scottcampbellRR/SolidWorksFiles/Machined Parts - 2024-10-08/Front Housing.STEP

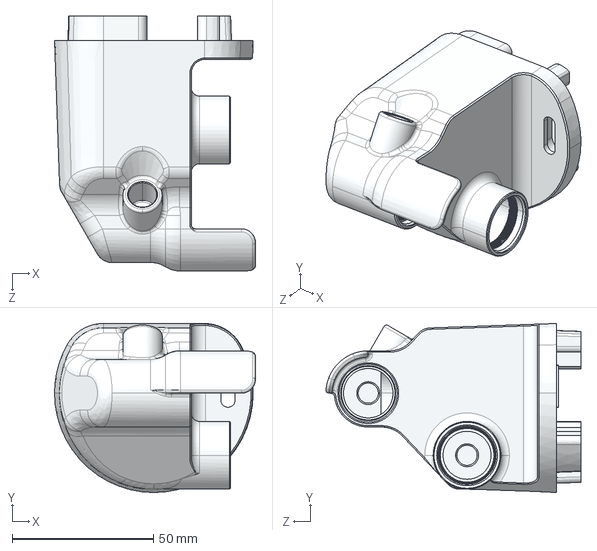
[picture p1: CAD file, 2024-12-03]
Machined Parts - 2024-10-08/Front Housing.STEP
71.2 x 59.9 x 90.3 mm
