scottcampbellRR/SolidWorksFiles/Machined Parts -2025-04-07-R01 RELEASED/RCDT-PR-003 - Bore Cap R01.STEP

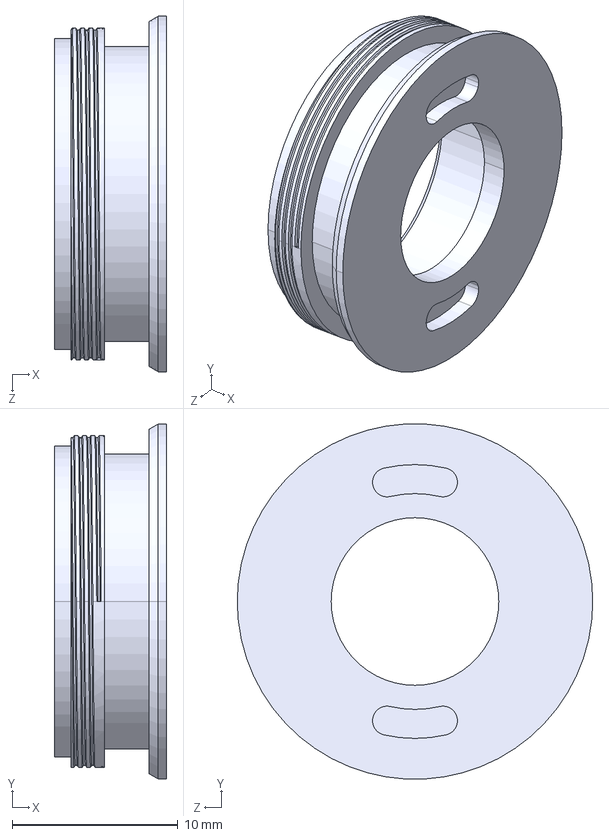
[picture p2: CAD file, 2025-04-08]
Machined Parts -2025-04-07-R01 RELEASED/RCDT-PR-003 - Bore Cap R01.STEP
6.75 x 21.4 x 21.4 mm
