scottcampbellRR/SolidWorksFiles/Machined Parts -2025-04-07-R01 RELEASED/RCDT-PR-004 Guard R01.STEP

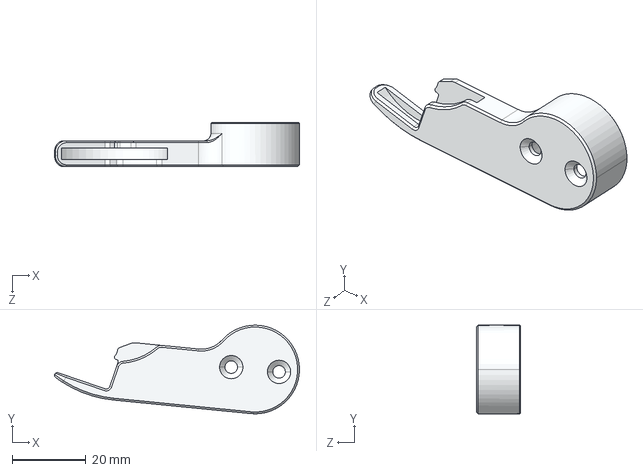
[picture p3: CAD file, 2025-04-08]
Machined Parts -2025-04-07-R01 RELEASED/RCDT-PR-004 Guard R01.STEP
66.3 x 24.0 x 12.0 mm
