scottcampbellRR/SolidWorksFiles/Machined Parts -2025-04-07-R01 RELEASED/RCDT-PR-001 Front Housing R02.STEP

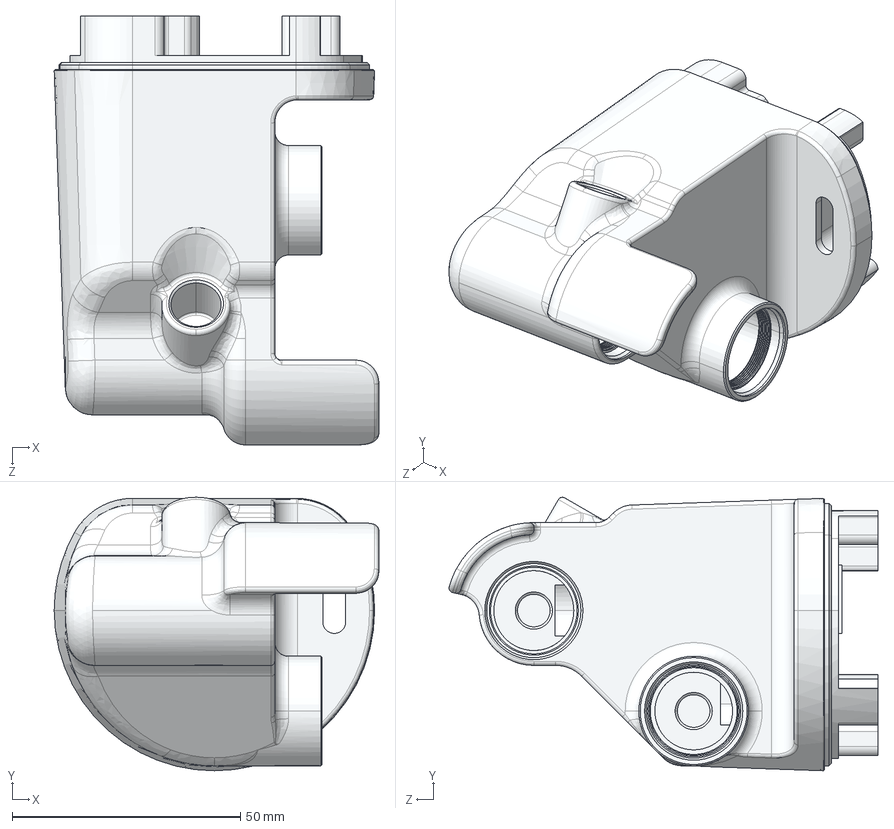
[picture p4: CAD file, 2025-04-08]
Machined Parts -2025-04-07-R01 RELEASED/RCDT-PR-001 Front Housing R02.STEP
71.1 x 59.9 x 93.9 mm
