scottcampbellRR/SolidWorksFiles/Machined Parts -2025-04-07-R01 RELEASED/RCDT-PR-008 Guard Shaft Collar R01.STEP

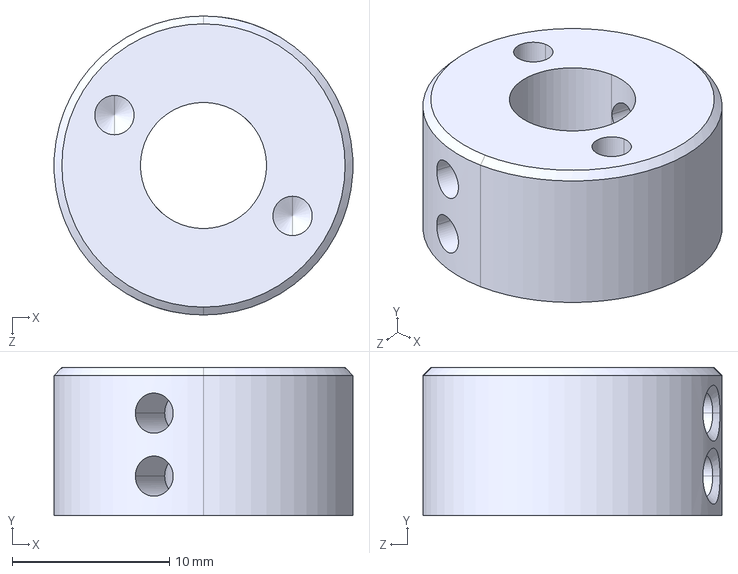
[picture p6: CAD file, 2025-04-08]
Machined Parts -2025-04-07-R01 RELEASED/RCDT-PR-008 Guard Shaft Collar R01.STEP
19.0 x 9.40 x 19.0 mm
