scottcampbellRR/SolidWorksFiles/Machined Parts -2025-04-07-R01 RELEASED/RCDT-PR-005 Blade Lock R01.STEP

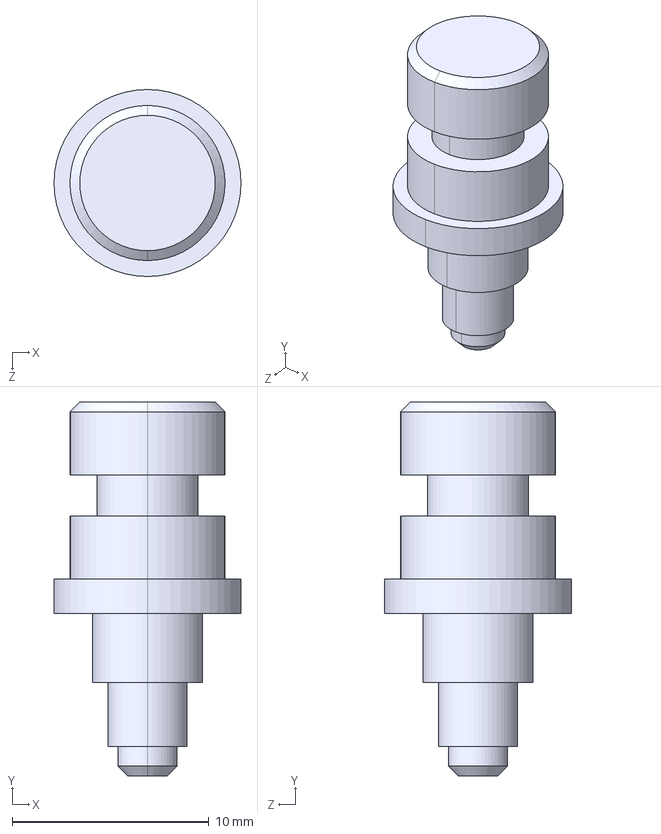
[picture p7: CAD file, 2025-04-08]
Machined Parts -2025-04-07-R01 RELEASED/RCDT-PR-005 Blade Lock R01.STEP
9.50 x 19.0 x 9.50 mm
