scottcampbellRR/SolidWorksFiles/Machined Parts -2025-04-07-R01 RELEASED/RCDT-PR-002 - Driveshaft R01.STEP

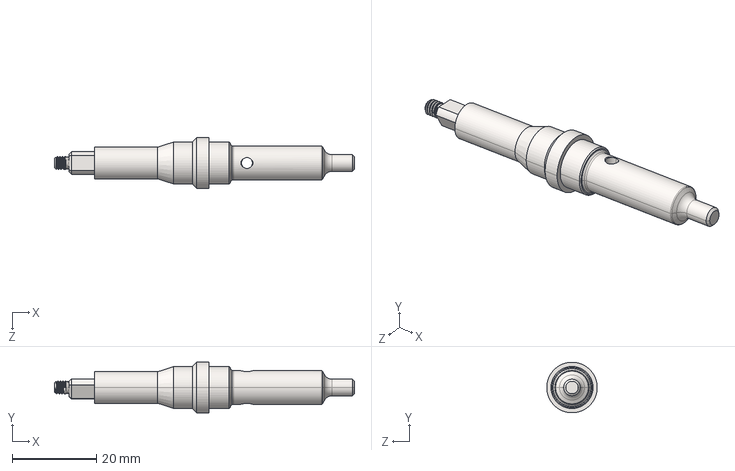
[picture p8: CAD file, 2025-04-08]
Machined Parts -2025-04-07-R01 RELEASED/RCDT-PR-002 - Driveshaft R01.STEP
71.2 x 12.0 x 12.0 mm
