scottcampbellRR/SolidWorksFiles/Machined Parts -2025-04-07-R01 RELEASED/RCDT-PR-007 Actuator Arm R01.STEP

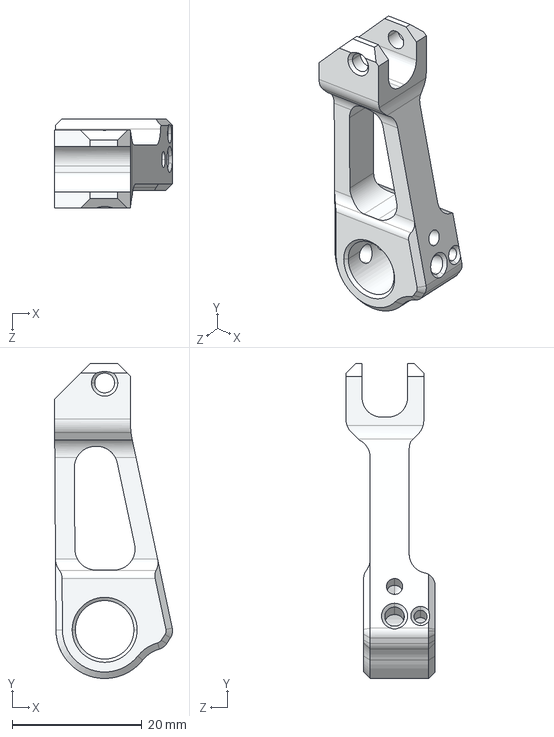
[picture p10: CAD file, 2025-04-08]
Machined Parts -2025-04-07-R01 RELEASED/RCDT-PR-007 Actuator Arm R01.STEP
18.2 x 48.5 x 13.8 mm
