scottcampbellRR/SolidWorksFiles/Machined Parts - 2024-10-08/Guard.STEP

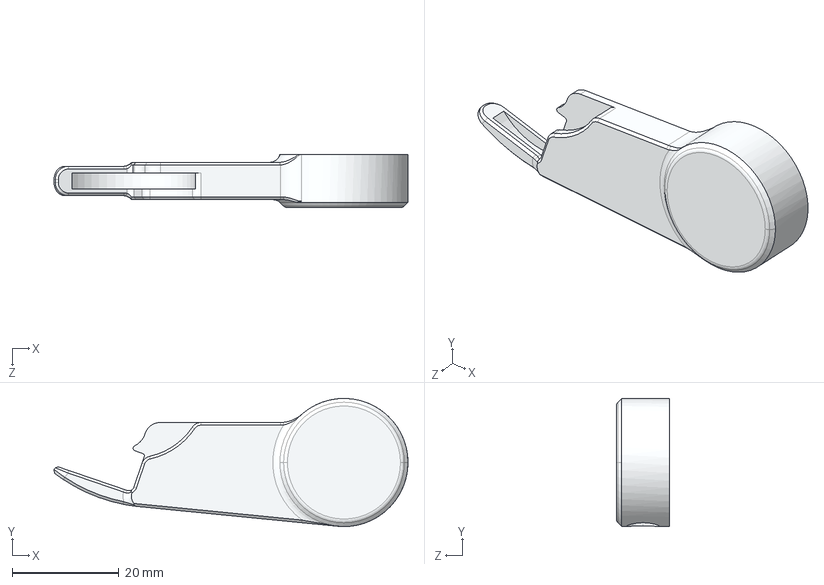
[picture p11: CAD file, 2024-12-03]
Machined Parts - 2024-10-08/Guard.STEP
66.3 x 24.0 x 10.0 mm
