scottcampbellRR/SolidWorksFiles/Machined Parts -2025-04-07-R01 RELEASED/RCDT-PR-006 Guard Shaft R01.STEP

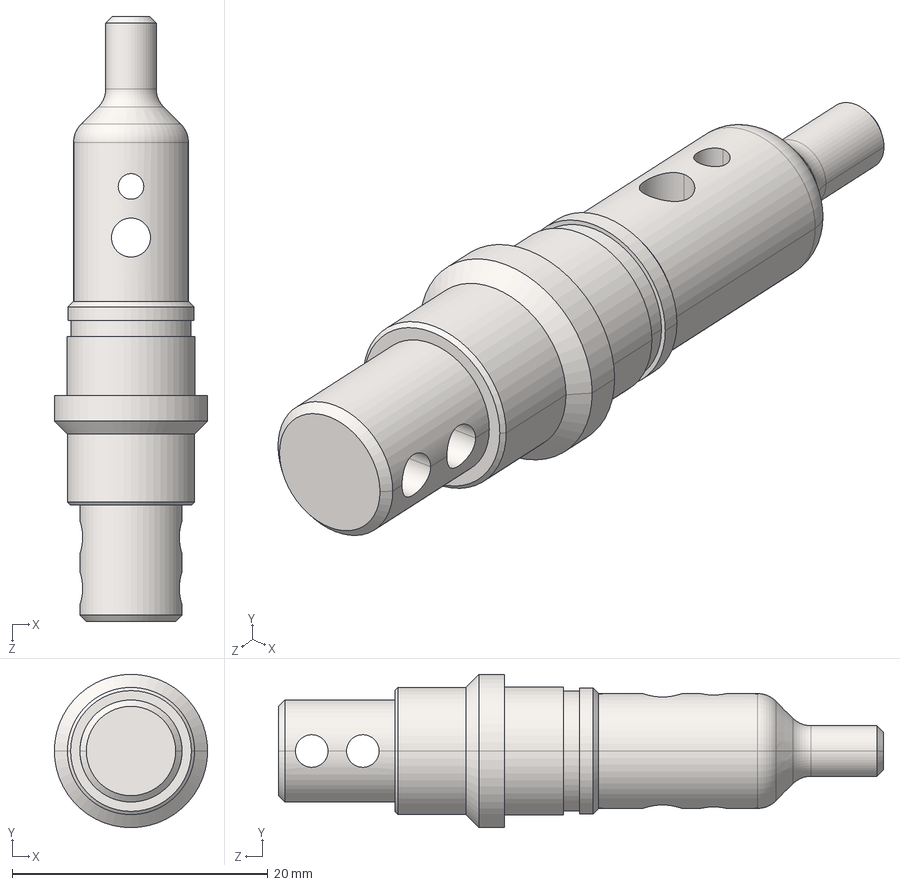
[picture p12: CAD file, 2025-04-08]
Machined Parts -2025-04-07-R01 RELEASED/RCDT-PR-006 Guard Shaft R01.STEP
12.0 x 12.0 x 47.4 mm
