scottcampbellRR/SolidWorksFiles/Machined Parts - 2024-10-08/Actuator Arm.STEP

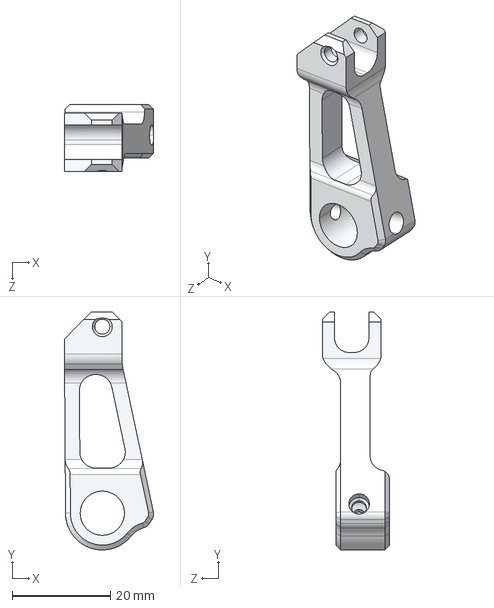
[picture p13: CAD file, 2024-12-03]
Machined Parts - 2024-10-08/Actuator Arm.STEP
18.2 x 48.5 x 13.8 mm
