scottcampbellRR/SolidWorksFiles/Machined Parts - 2024-10-08/Driveshaft.STEP

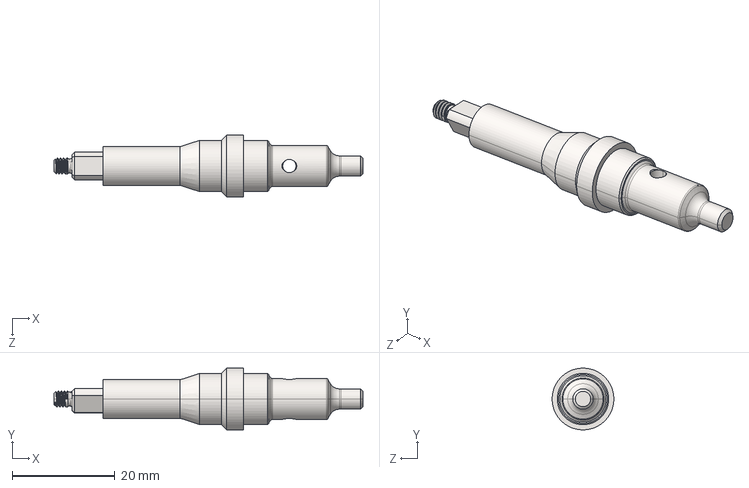
[picture p14: CAD file, 2024-12-03]
Machined Parts - 2024-10-08/Driveshaft.STEP
60.0 x 12.0 x 12.0 mm
