scottcampbellRR/SolidWorksFiles/Machined Parts - 2024-10-08/Shoulder Bolt.STEP

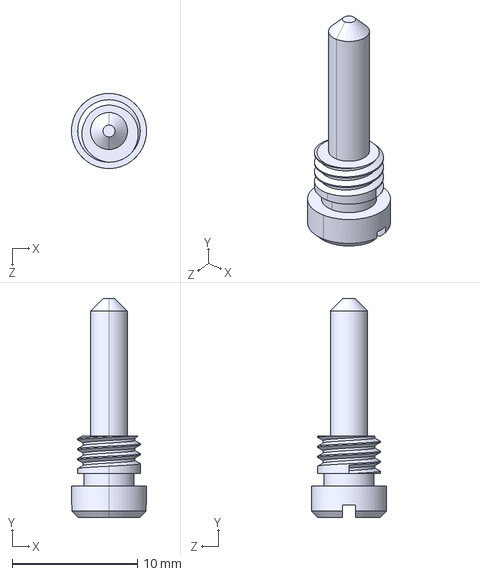
[picture p16: CAD file, 2024-12-03]
Machined Parts - 2024-10-08/Shoulder Bolt.STEP
6.00 x 17.5 x 6.00 mm
