scottcampbellRR/SolidWorksFiles/(list of files, cad)

Other CAD files:
Machined Parts - 2024-10-08/Front Housing_REV2.STEP
Machined Parts - 2024-10-08/Bore Cap.STEP
Machined Parts - 2024-10-08/Thumbscrew.STEP
