scottcampbellRR/SolidWorksFiles/Machined Parts -2025-04-07-R01 RELEASED/RCDT-PR-004 Guard Drawing R01.PDF

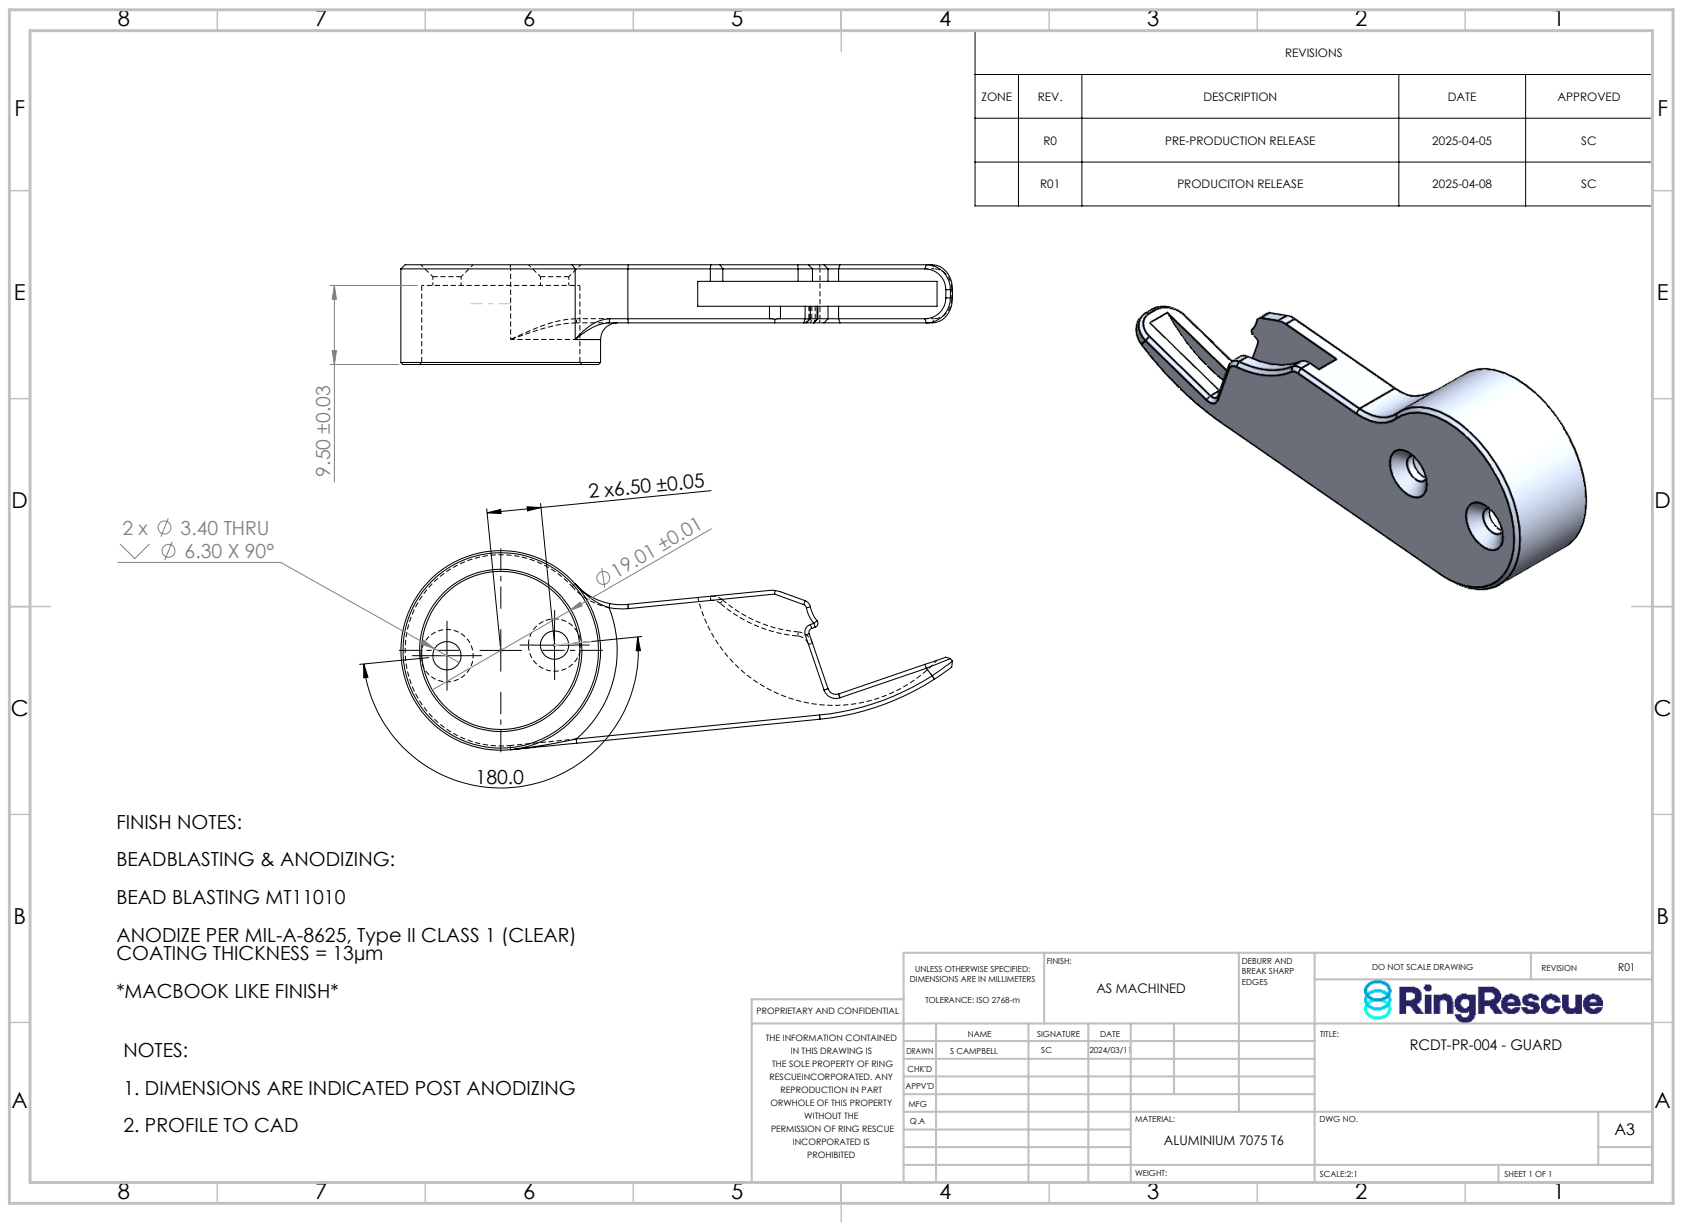
[picture p20: page 1]
3.40 THRU; FINISH:; DEBURR AND; BREAK SHARP; DO NOT SCALE DRAWING; REVISION; SCALE:2:1; SHEET 1 OF 1; AS MACHINED

REVISIONS

ZONE | REV. | DESCRIPTION | DATE | APPROVED

R0 | PRE-PRODUCTION RELEASE | 2025-04-05 | SC

R01 | PRODUCITON RELEASE | 2025-04-08 | SC

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

UNLESS OTHERWISE SPECIFIED:
DIMENSIONS ARE IN MILLIMETERS
TOLERANCE: ISO 2768-m

PROPRIETARY AND CONFIDENTIAL

NOTES:
1. DIMENSIONS ARE INDICATED POST ANODIZING
2. PROFILE TO CAD

IN THIS DRAWING IS THE SOLE PROPERTY OF RING RESCUEINCORPORATED. ANY REPRODUCTION IN PART ORWHOLE OF THIS PROPERTY WITHOUT THE PERMISSION OF RING RESCUE INCORPORATED IS PROHIBITED | | NAME | SIGNATURE THE INFORMATION CONTAINED | DATE | | | TITLE: RCDT-PR-004 - GUARD

DRAWN | S CAMPBELL | SC | 2024/03/11
CHK'D
APPV'D
MFG
Q.A | | | | MATERIAL: | DWG NO. | A3 ALUMINIUM 7075 T6
