scottcampbellRR/SolidWorksFiles/Machined Parts -2025-04-07-R01 RELEASED/RCDT-PR-005 Blade Lock Drawing R01.PDF

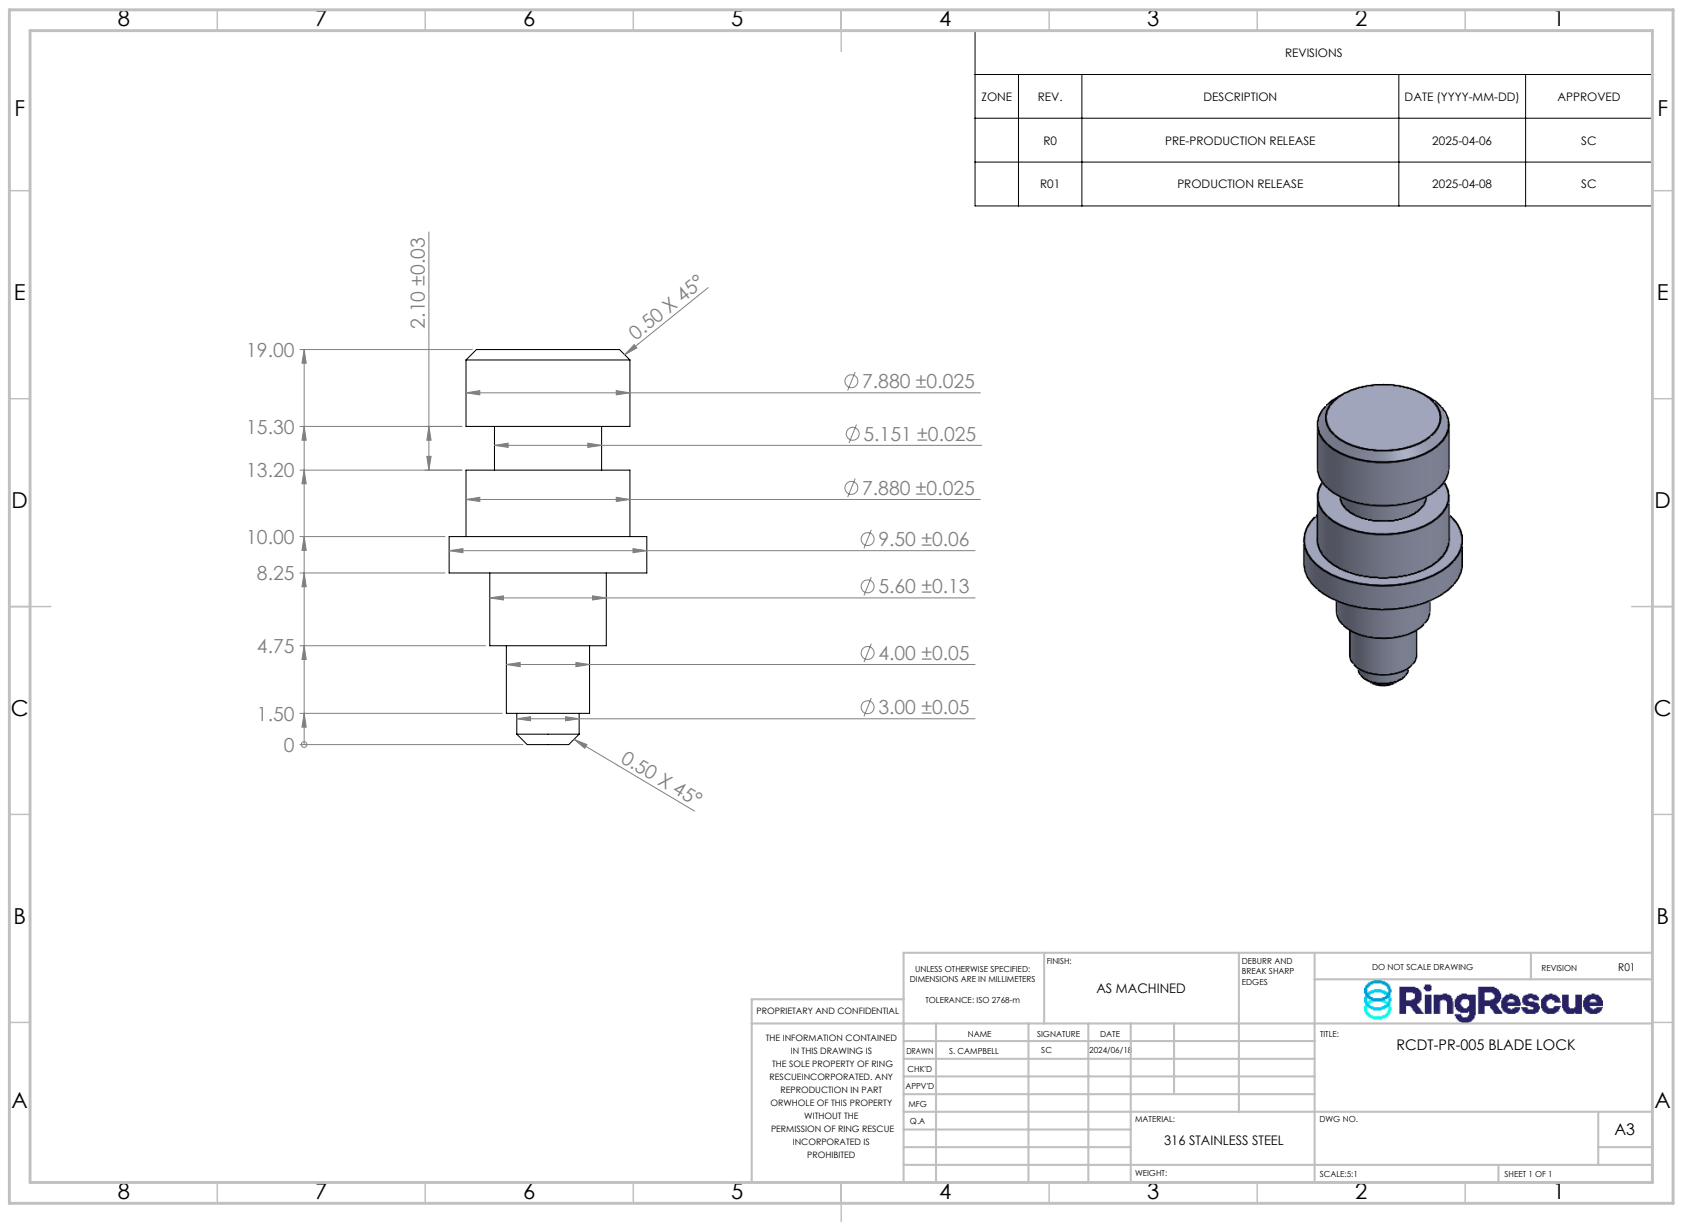
[picture p21: page 1]
FINISH:; DEBURR AND; BREAK SHARP; DO NOT SCALE DRAWING; REVISION; SCALE:5:1; SHEET 1 OF 1; AS MACHINED

REVISIONS

ZONE | REV. | DESCRIPTION | DATE (YYYY-MM-DD) | APPROVED

R0 | PRE-PRODUCTION RELEASE | 2025-04-06 | SC

R01 | PRODUCTION RELEASE | 2025-04-08 | SC

UNLESS OTHERWISE SPECIFIED:
DIMENSIONS ARE IN MILLIMETERS
TOLERANCE: ISO 2768-m

PROPRIETARY AND CONFIDENTIAL

IN THIS DRAWING IS THE SOLE PROPERTY OF RING RESCUEINCORPORATED. ANY REPRODUCTION IN PART ORWHOLE OF THIS PROPERTY WITHOUT THE PERMISSION OF RING RESCUE INCORPORATED IS PROHIBITED | | NAME | SIGNATURE THE INFORMATION CONTAINED | DATE | | | TITLE: RCDT-PR-005 BLADE LOCK

DRAWN | S. CAMPBELL | SC | 2024/06/18
CHK'D
APPV'D
MFG
Q.A | | | | MATERIAL: | DWG NO. | A3 316 STAINLESS STEEL
