scottcampbellRR/SolidWorksFiles/Machined Parts -2025-04-07-R01 RELEASED/RCDT-PR-006 Guard Shaft Drawing R01.PDF

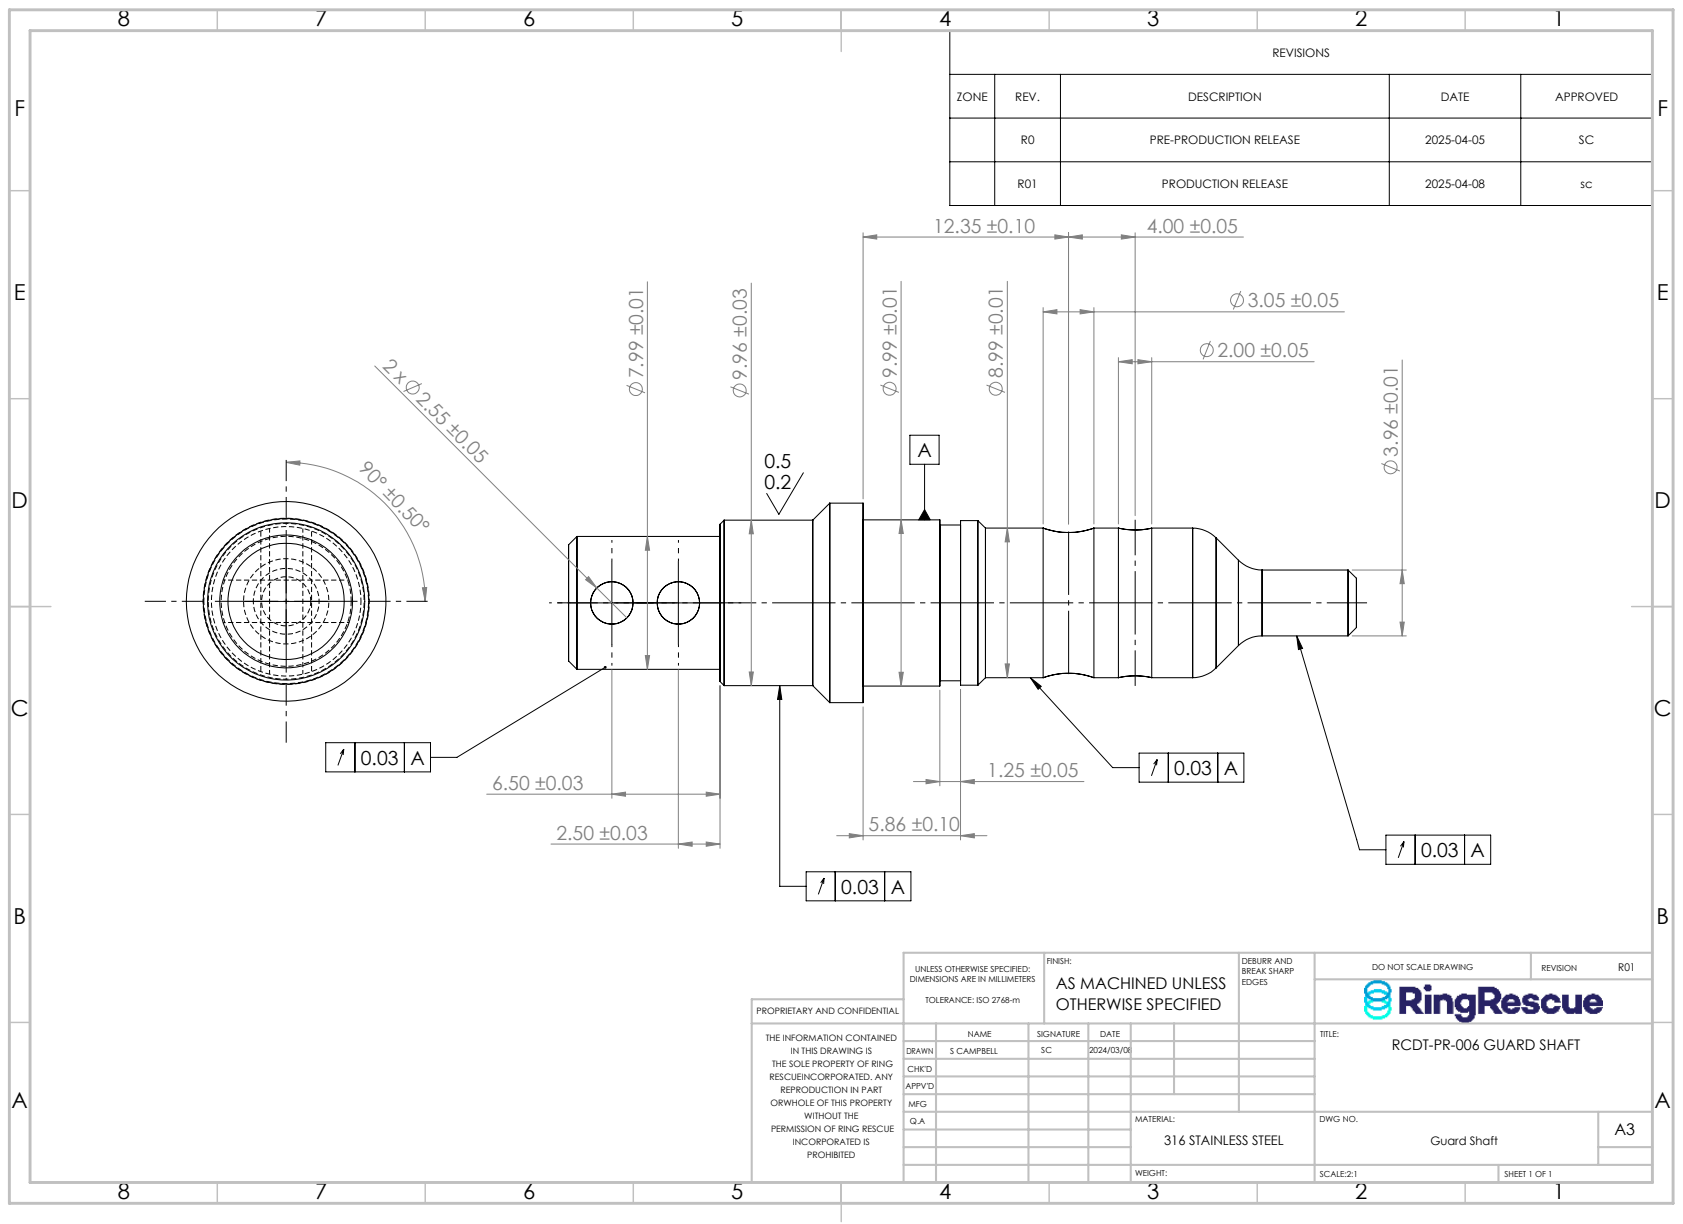
[picture p22: page 1]
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

REVISIONS

ZONE | REV. | DESCRIPTION | DATE | APPROVED

R0 | PRE-PRODUCTION RELEASE | 2025-04-05 | SC

R01 | PRODUCTION RELEASE | 2025-04-08 | sc

AS MACHINED UNLESS
OTHERWISE SPECIFIED

UNLESS OTHERWISE SPECIFIED:
DIMENSIONS ARE IN MILLIMETERS
TOLERANCE: ISO 2768-m

PROPRIETARY AND CONFIDENTIAL

IN THIS DRAWING IS THE SOLE PROPERTY OF RING RESCUEINCORPORATED. ANY REPRODUCTION IN PART ORWHOLE OF THIS PROPERTY WITHOUT THE PERMISSION OF RING RESCUE INCORPORATED IS PROHIBITED | | NAME | SIGNATURE THE INFORMATION CONTAINED | DATE | | | TITLE: RCDT-PR-006 GUARD SHAFT

DRAWN | S CAMPBELL | SC | 2024/03/08
CHK'D
APPV'D
MFG
Q.A | | | | MATERIAL: | DWG NO. Guard Shaft | A3 316 STAINLESS STEEL
