scottcampbellRR/SolidWorksFiles/Machined Parts -2025-04-07-R01 RELEASED/RDCT-PR-001 Front Housing Drawing R01.PDF

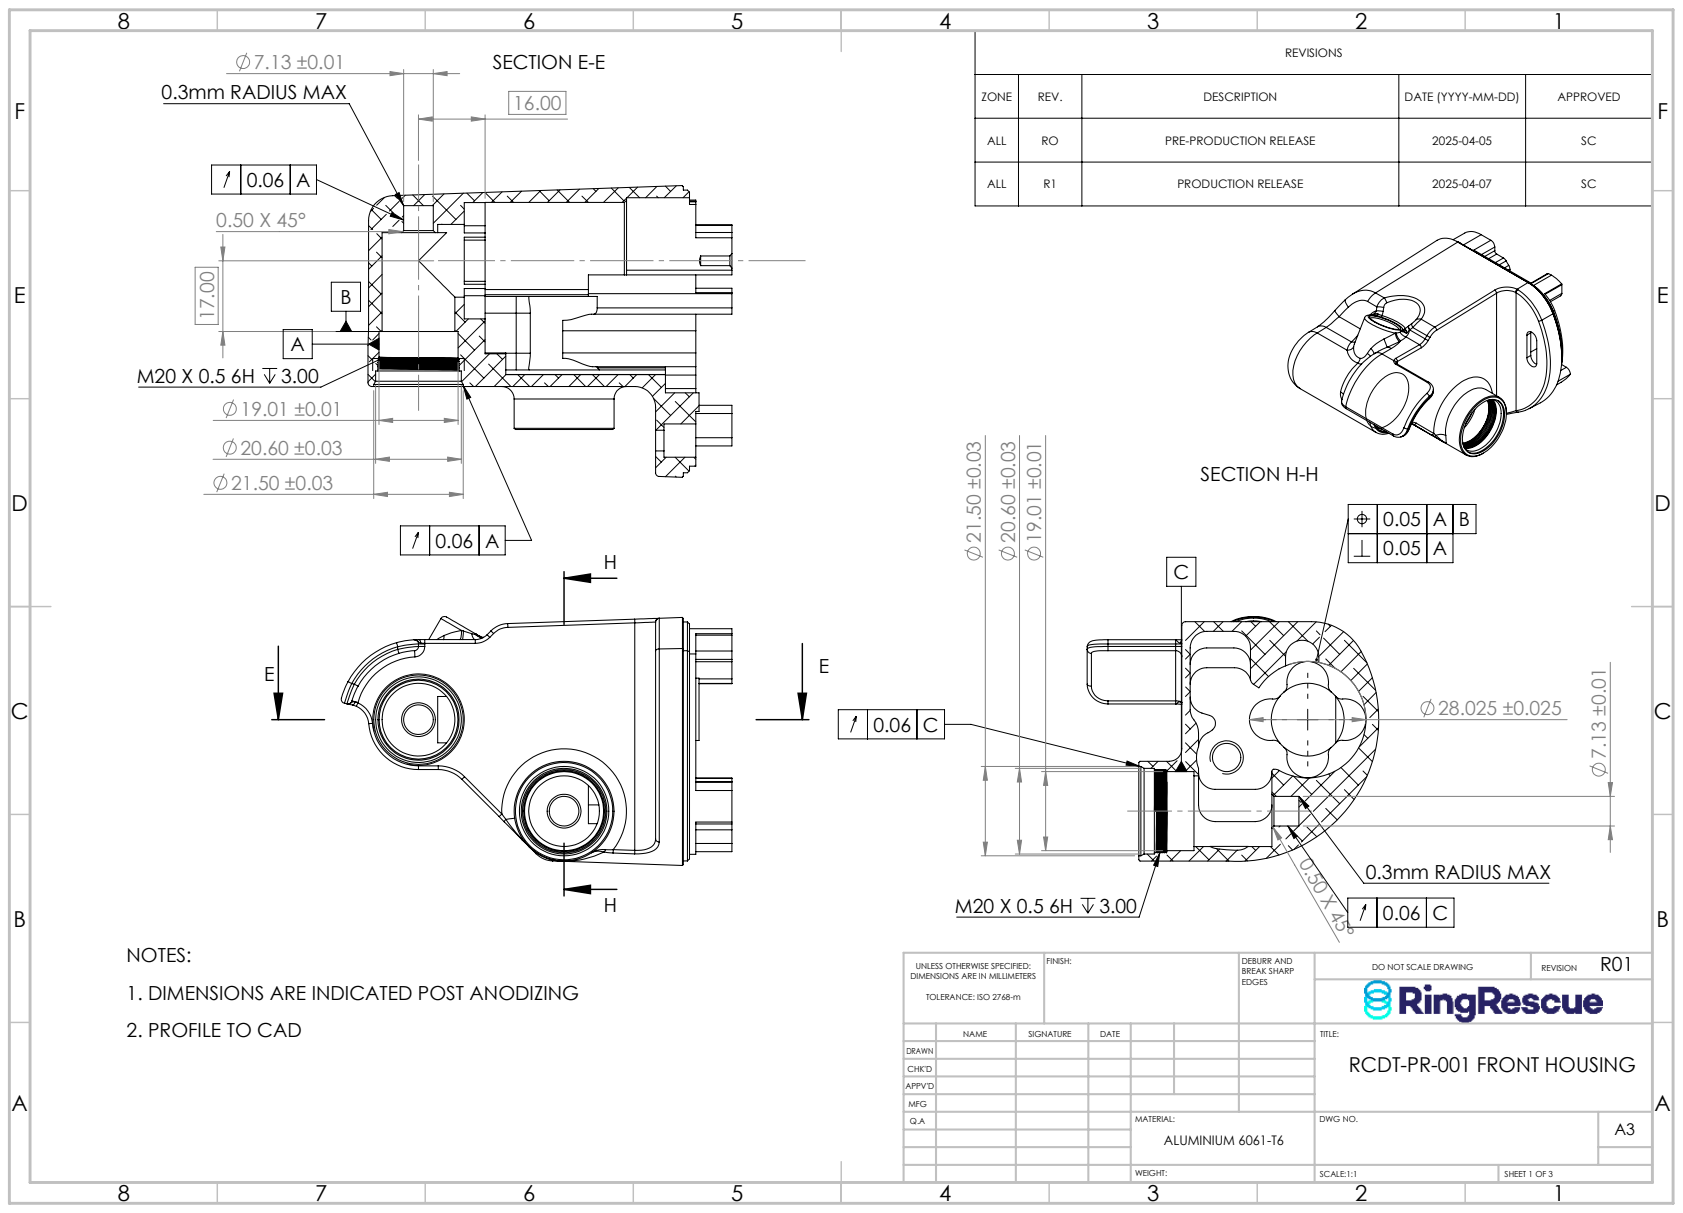
[picture p23: page 1]
0.3mm RADIUS MAX; SECTION H-H; FINISH:; DEBURR AND; BREAK SHARP; DO NOT SCALE DRAWING; REVISION; SCALE:1:1; SHEET 1 OF 3

SECTION E-E 7.13 ±0.01 | REVISIONS

ZONE | REV. | DESCRIPTION | DATE (YYYY-MM-DD) | APPROVED

ALL | RO | PRE-PRODUCTION RELEASE | 2025-04-05 | SC

ALL | R1 | PRODUCTION RELEASE | 2025-04-07 | SC

NOTES:
1. DIMENSIONS ARE INDICATED POST ANODIZING
2. PROFILE TO CAD

UNLESS OTHERWISE SPECIFIED:
DIMENSIONS ARE IN MILLIMETERS
TOLERANCE: ISO 2768-m

NAME | SIGNATURE | DATE | | | | TITLE: RCDT-PR-001 FRONT HOUSING

DRAWN
CHK'D
APPV'D
MFG
Q.A | | | | MATERIAL: | DWG NO. | A3 ALUMINIUM 6061-T6

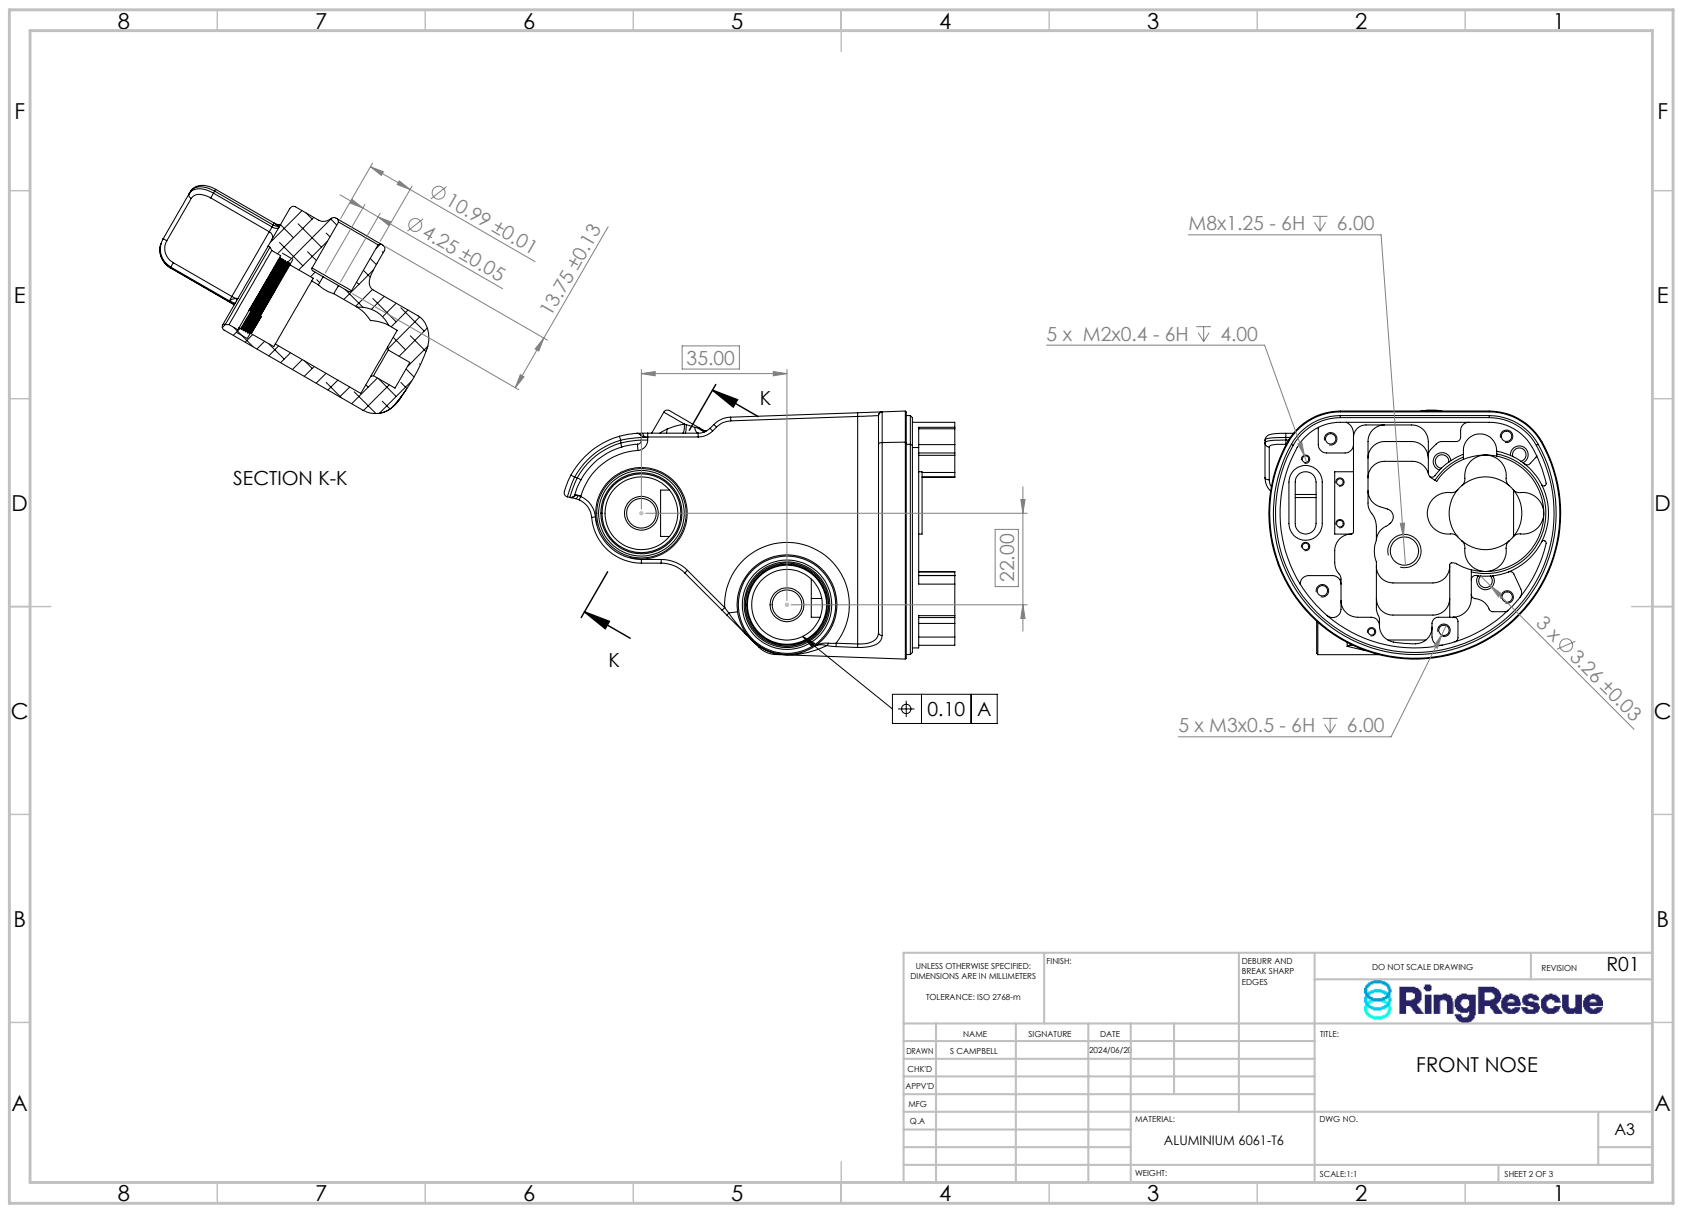
[picture p24: page 2]
SECTION K-K; FINISH:; DEBURR AND; BREAK SHARP; DO NOT SCALE DRAWING; REVISION

UNLESS OTHERWISE SPECIFIED:
DIMENSIONS ARE IN MILLIMETERS
TOLERANCE: ISO 2768-m

NAME | SIGNATURE | DATE | TITLE:

DRAWN | | | 2024/06/20 | FRONT NOSE S CAMPBELL
CHK'D
APPV'D
MFG

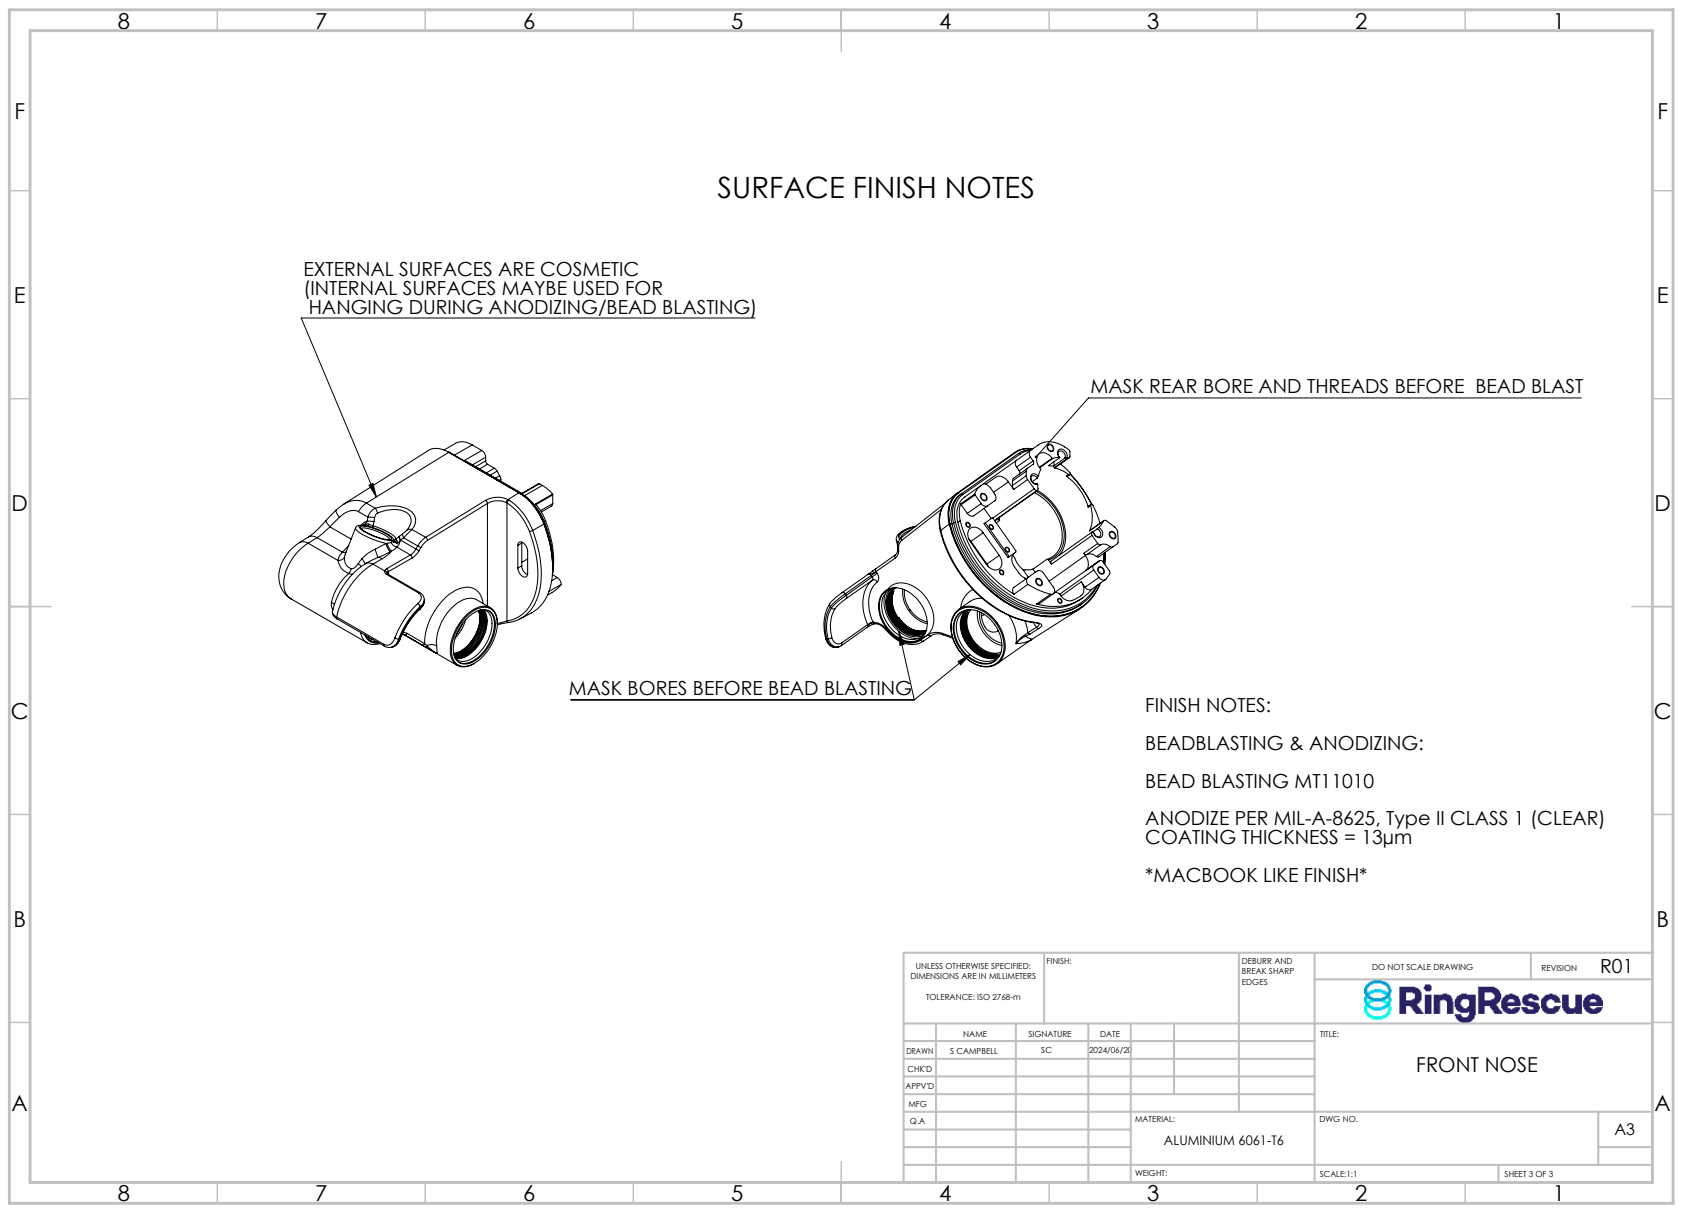
[picture p25: page 3]
FINISH:; DEBURR AND; BREAK SHARP; DO NOT SCALE DRAWING; REVISION

SURFACE FINISH NOTES

EXTERNAL SURFACES ARE COSMETIC
(INTERNAL SURFACES MAYBE USED FOR
HANGING DURING ANODIZING/BEAD BLASTING)

MASK REAR BORE AND THREADS BEFORE BEAD BLAST

MASK BORES BEFORE BEAD BLASTING

FINISH NOTES:
BEADBLASTING & ANODIZING:
BEAD BLASTING MT11010
ANODIZE PER MIL-A-8625, Type II CLASS 1 (CLEAR)
COATING THICKNESS = 13µm
*MACBOOK LIKE FINISH*

UNLESS OTHERWISE SPECIFIED:
DIMENSIONS ARE IN MILLIMETERS
TOLERANCE: ISO 2768-m

NAME | SIGNATURE | DATE | TITLE:

DRAWN | | SC | 2024/06/20 | FRONT NOSE S CAMPBELL
CHK'D
APPV'D
MFG
