scottcampbellRR/SolidWorksFiles/Machined Parts - 2025-04-07-R0 RELEASED/RCDT-PR-007 Actuator Arm Drawing R0.PDF

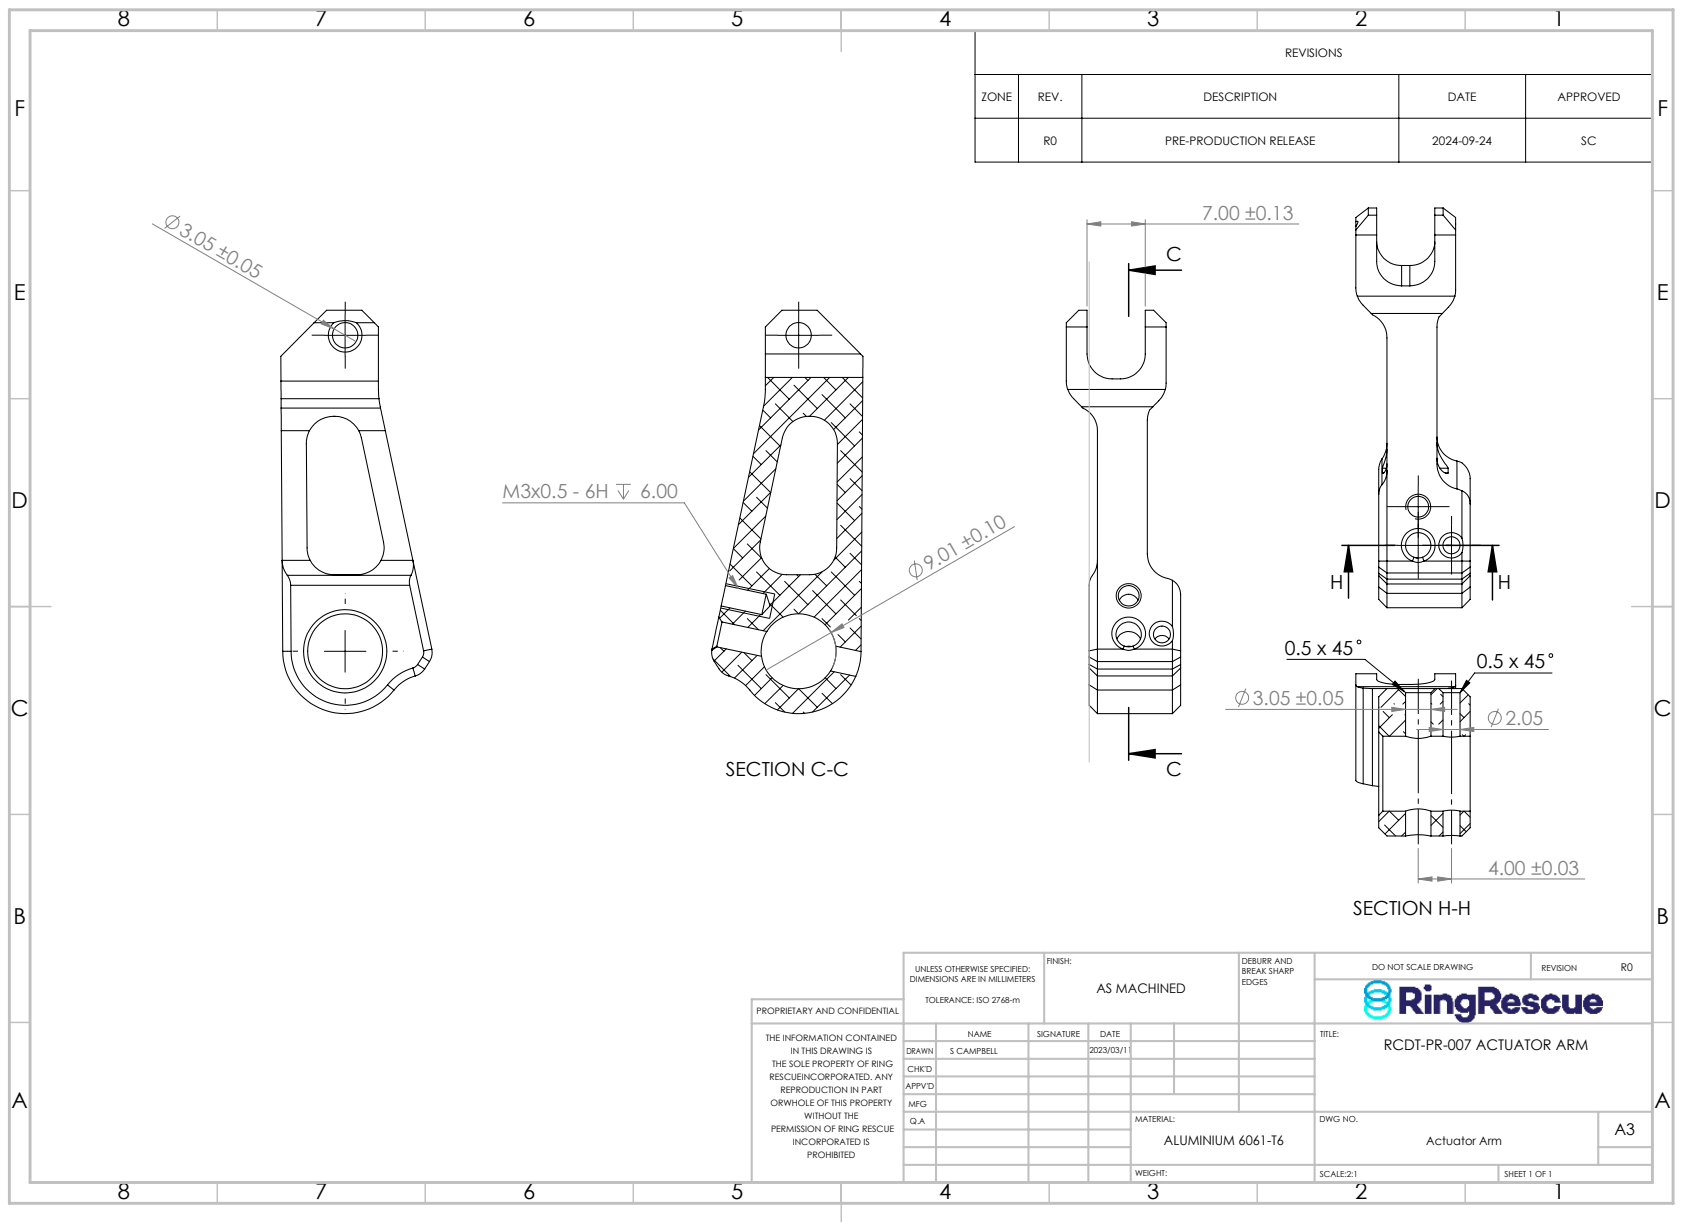
[picture p26: page 1]
SECTION C-C; SECTION H-H; FINISH:; DEBURR AND; BREAK SHARP; DO NOT SCALE DRAWING; REVISION; SCALE:2:1; SHEET 1 OF 1; AS MACHINED

REVISIONS

ZONE | REV. | DESCRIPTION | DATE | APPROVED

R0 | PRE-PRODUCTION RELEASE | 2024-09-24 | SC

UNLESS OTHERWISE SPECIFIED:
DIMENSIONS ARE IN MILLIMETERS
TOLERANCE: ISO 2768-m

PROPRIETARY AND CONFIDENTIAL

IN THIS DRAWING IS THE SOLE PROPERTY OF RING RESCUEINCORPORATED. ANY REPRODUCTION IN PART ORWHOLE OF THIS PROPERTY WITHOUT THE PERMISSION OF RING RESCUE INCORPORATED IS PROHIBITED | | NAME | SIGNATURE THE INFORMATION CONTAINED | DATE | | | TITLE: RCDT-PR-007 ACTUATOR ARM

DRAWN | S CAMPBELL | | 2023/03/11
CHK'D
APPV'D
MFG
Q.A | | | | MATERIAL: | DWG NO. Actuator Arm | A3 ALUMINIUM 6061-T6
