scottcampbellRR/SolidWorksFiles/Machined Parts - 2024-10-08/Driveshaft Drawing.pdf

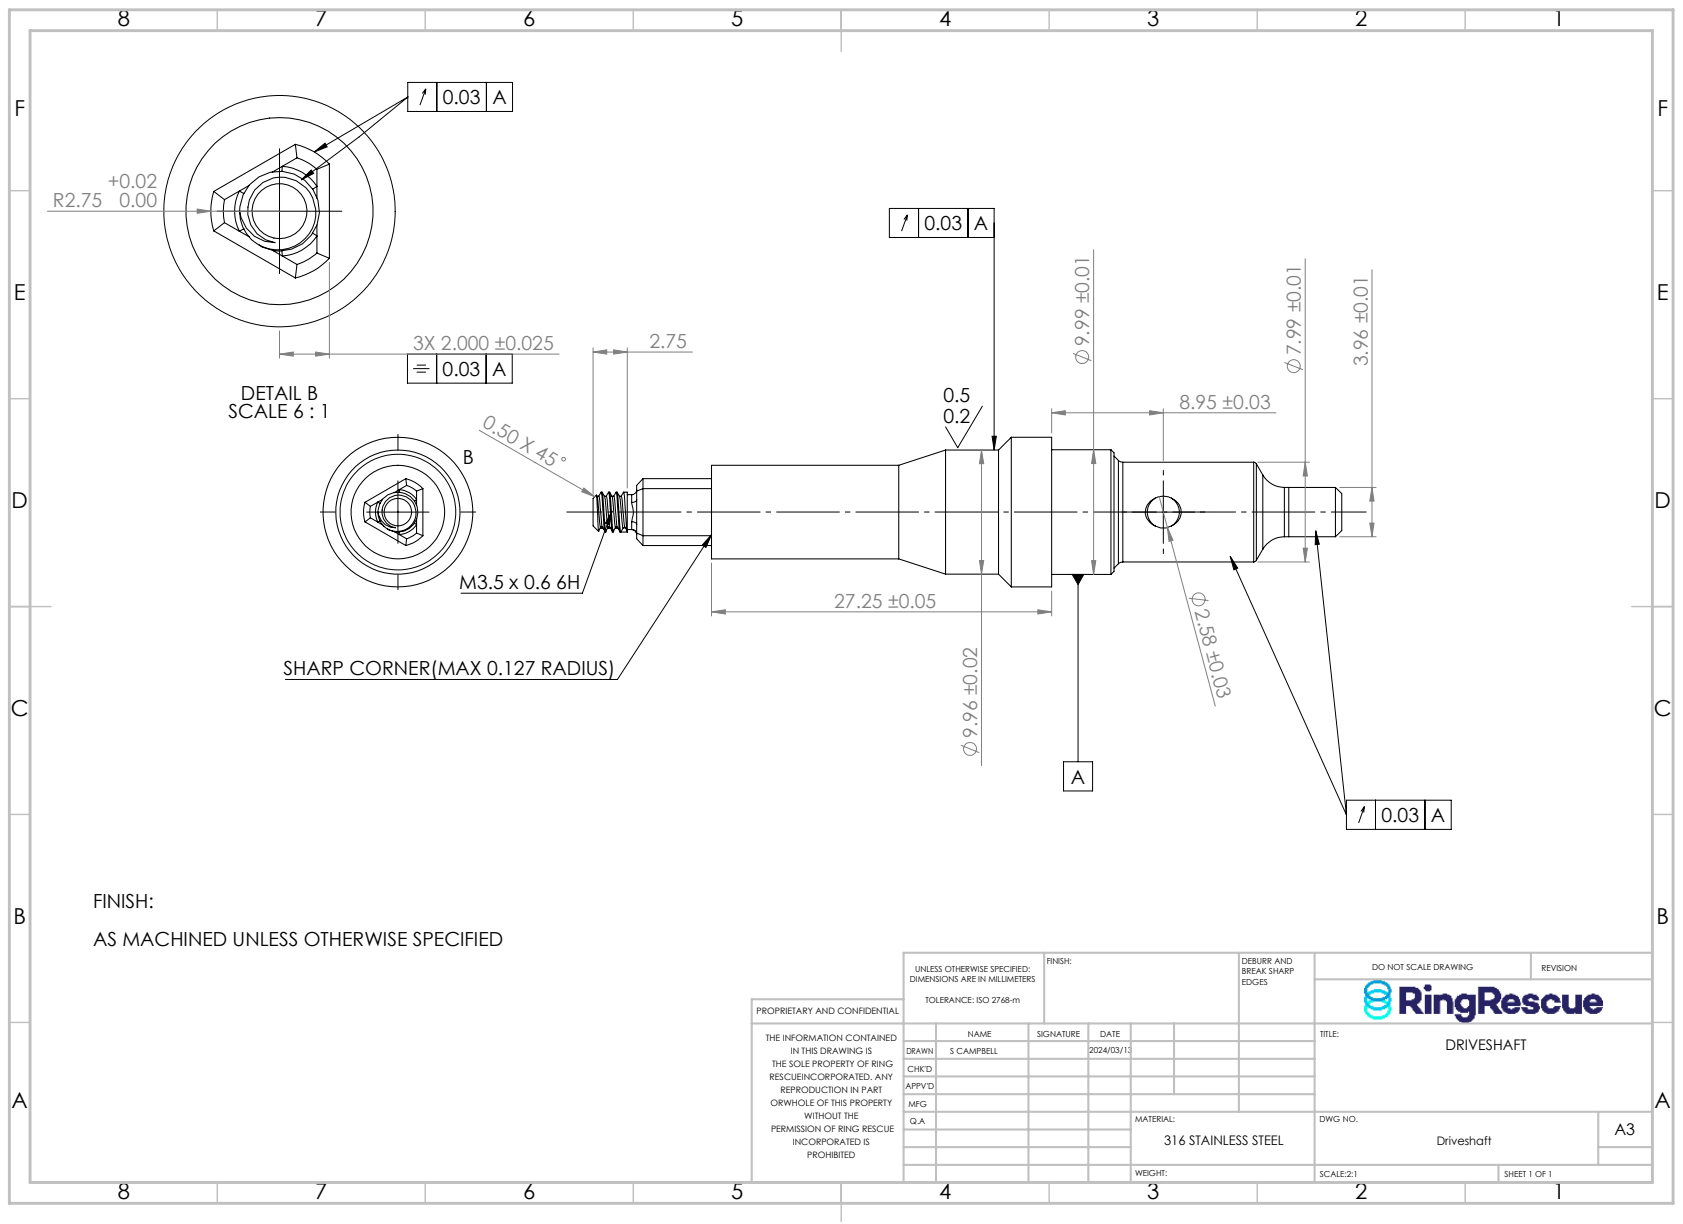
[picture p30: page 1]
DETAIL B SCALE 6 : 1; FINISH:; DEBURR AND; BREAK SHARP; DO NOT SCALE DRAWING; REVISION; SCALE:2:1; SHEET 1 OF 1

SHARP CORNER(MAX 0.127 RADIUS)

FINISH:
AS MACHINED UNLESS OTHERWISE SPECIFIED

UNLESS OTHERWISE SPECIFIED:
DIMENSIONS ARE IN MILLIMETERS
TOLERANCE: ISO 2768-m

PROPRIETARY AND CONFIDENTIAL

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

DRAWN | | | 2024/03/13 | | | DRIVESHAFT S CAMPBELL

CHK'D
APPV'D
MFG
Q.A | | | | MATERIAL: | DWG NO. Driveshaft | A3 316 STAINLESS STEEL
