scottcampbellRR/SolidWorksFiles/Machined Parts - 2024-10-08/Front Housing Drawing.pdf

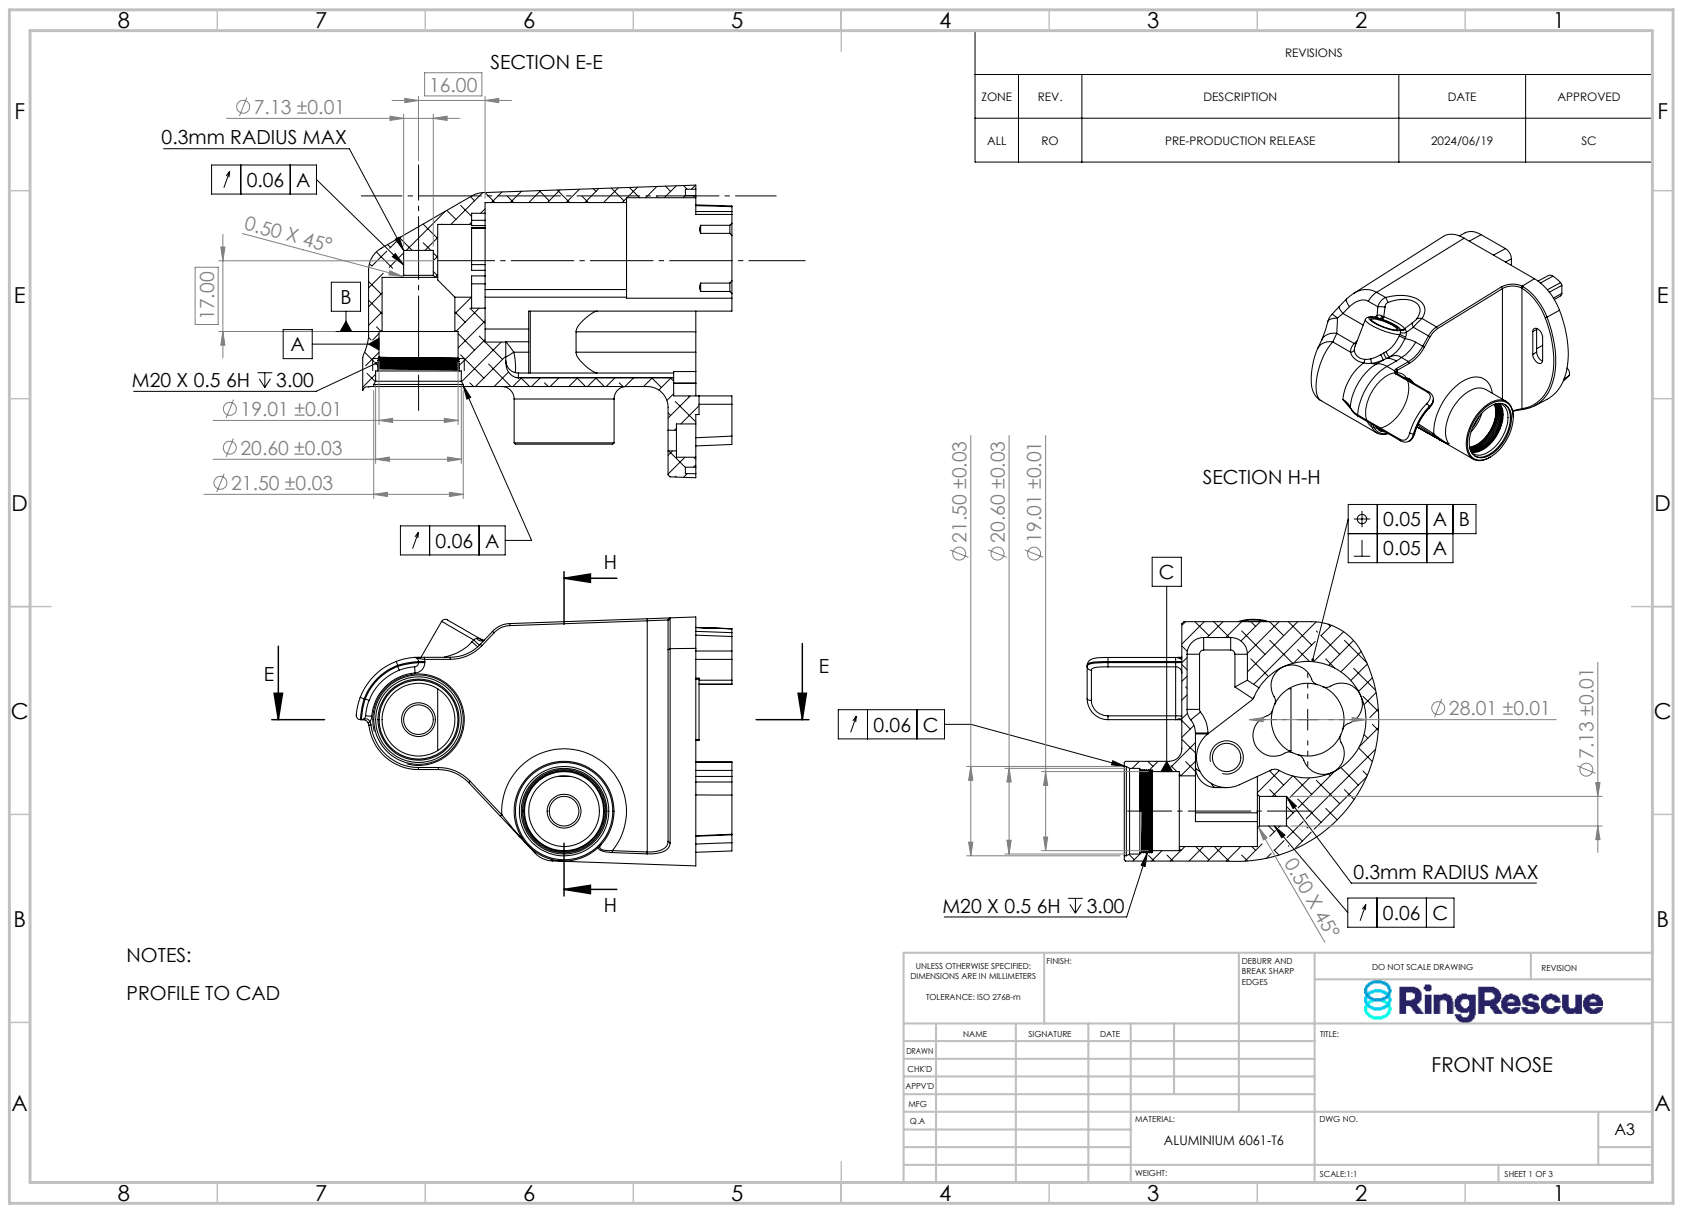
[picture p31: page 1]
SECTION E-E; 0.3mm RADIUS MAX; SECTION H-H; ALL; PRE-PRODUCTION RELEASE; FINISH:; DEBURR AND; BREAK SHARP; DO NOT SCALE DRAWING; REVISION; SCALE:1:1; SHEET 1 OF 3

NOTES:
PROFILE TO CAD

UNLESS OTHERWISE SPECIFIED:
DIMENSIONS ARE IN MILLIMETERS
TOLERANCE: ISO 2768-m

NAME | SIGNATURE | DATE | | | | TITLE: FRONT NOSE

DRAWN
CHK'D
APPV'D
MFG
Q.A | | | | MATERIAL: | DWG NO. | A3 ALUMINIUM 6061-T6

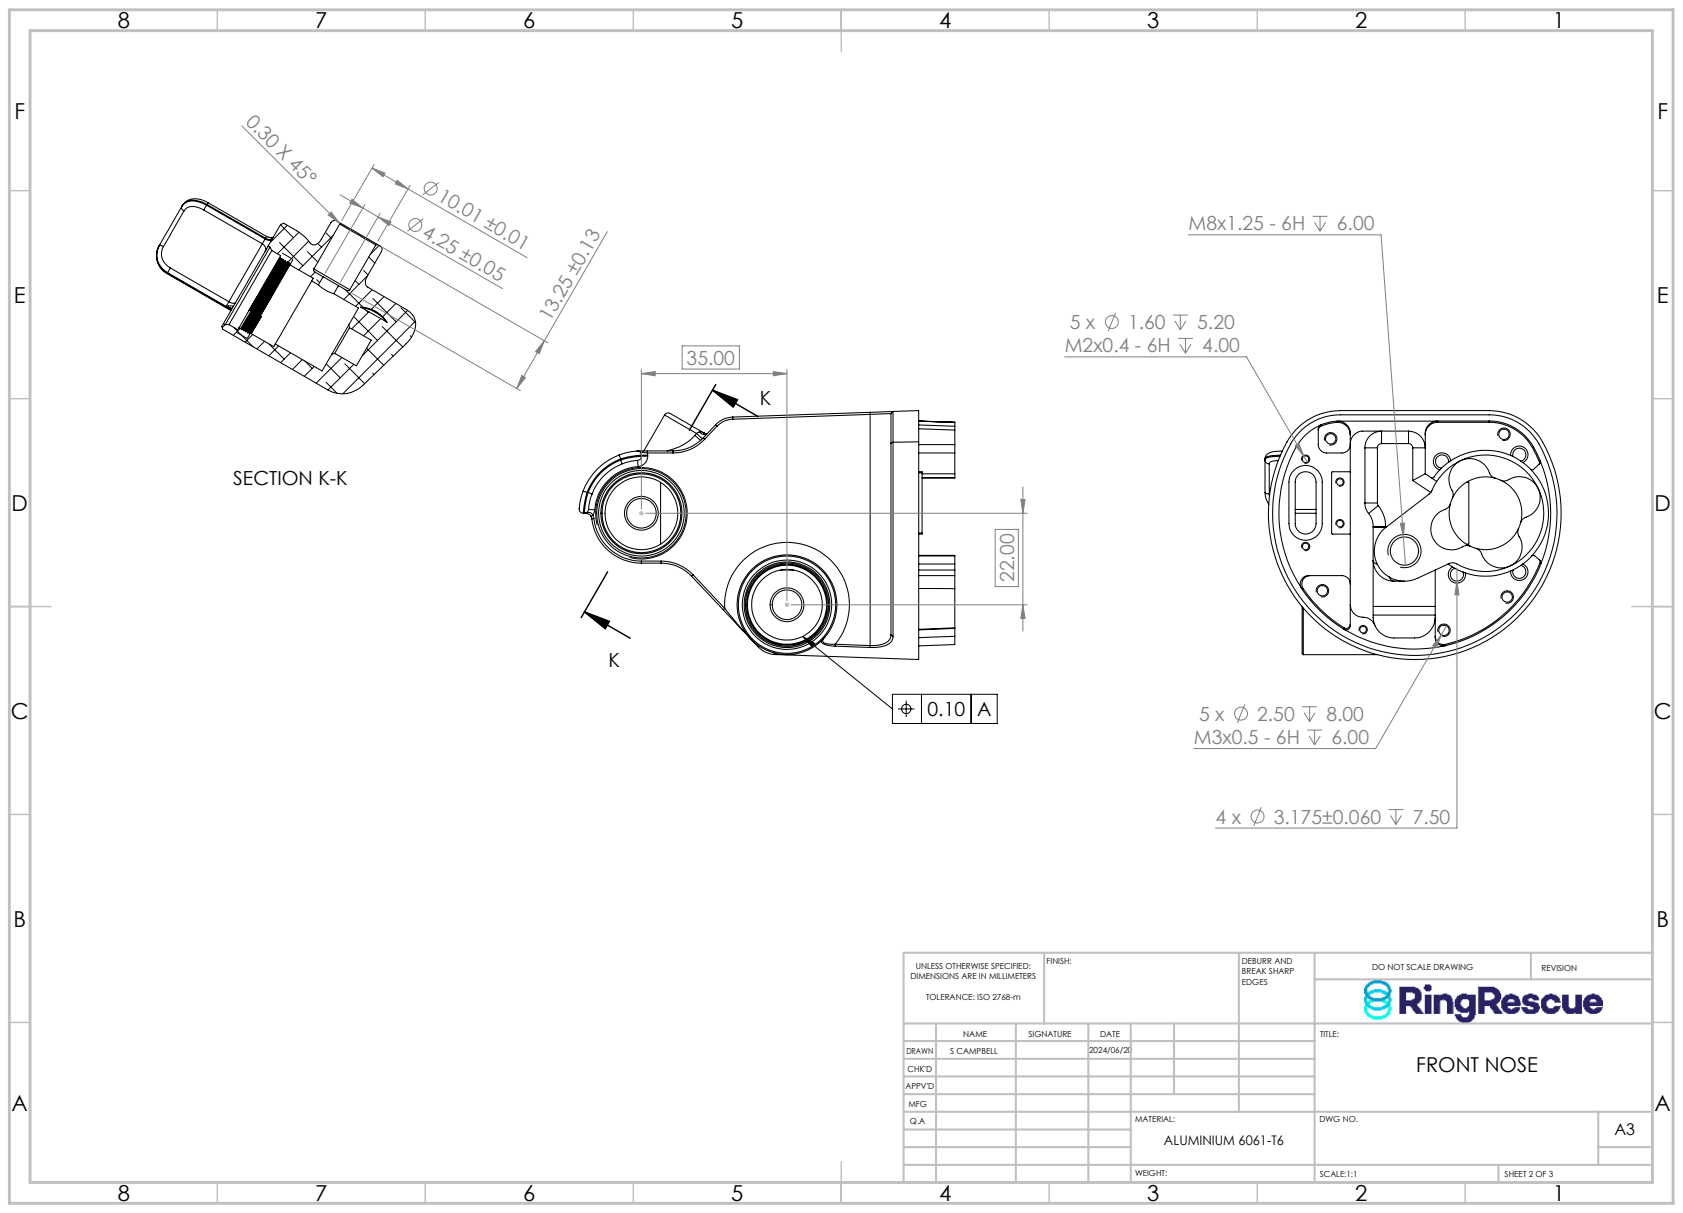
[picture p32: page 2]
SECTION K-K; FINISH:; DEBURR AND; BREAK SHARP; DO NOT SCALE DRAWING; REVISION

UNLESS OTHERWISE SPECIFIED:
DIMENSIONS ARE IN MILLIMETERS
TOLERANCE: ISO 2768-m

NAME | SIGNATURE | DATE | TITLE:

DRAWN | | | 2024/06/20 | FRONT NOSE S CAMPBELL
CHK'D
APPV'D
MFG

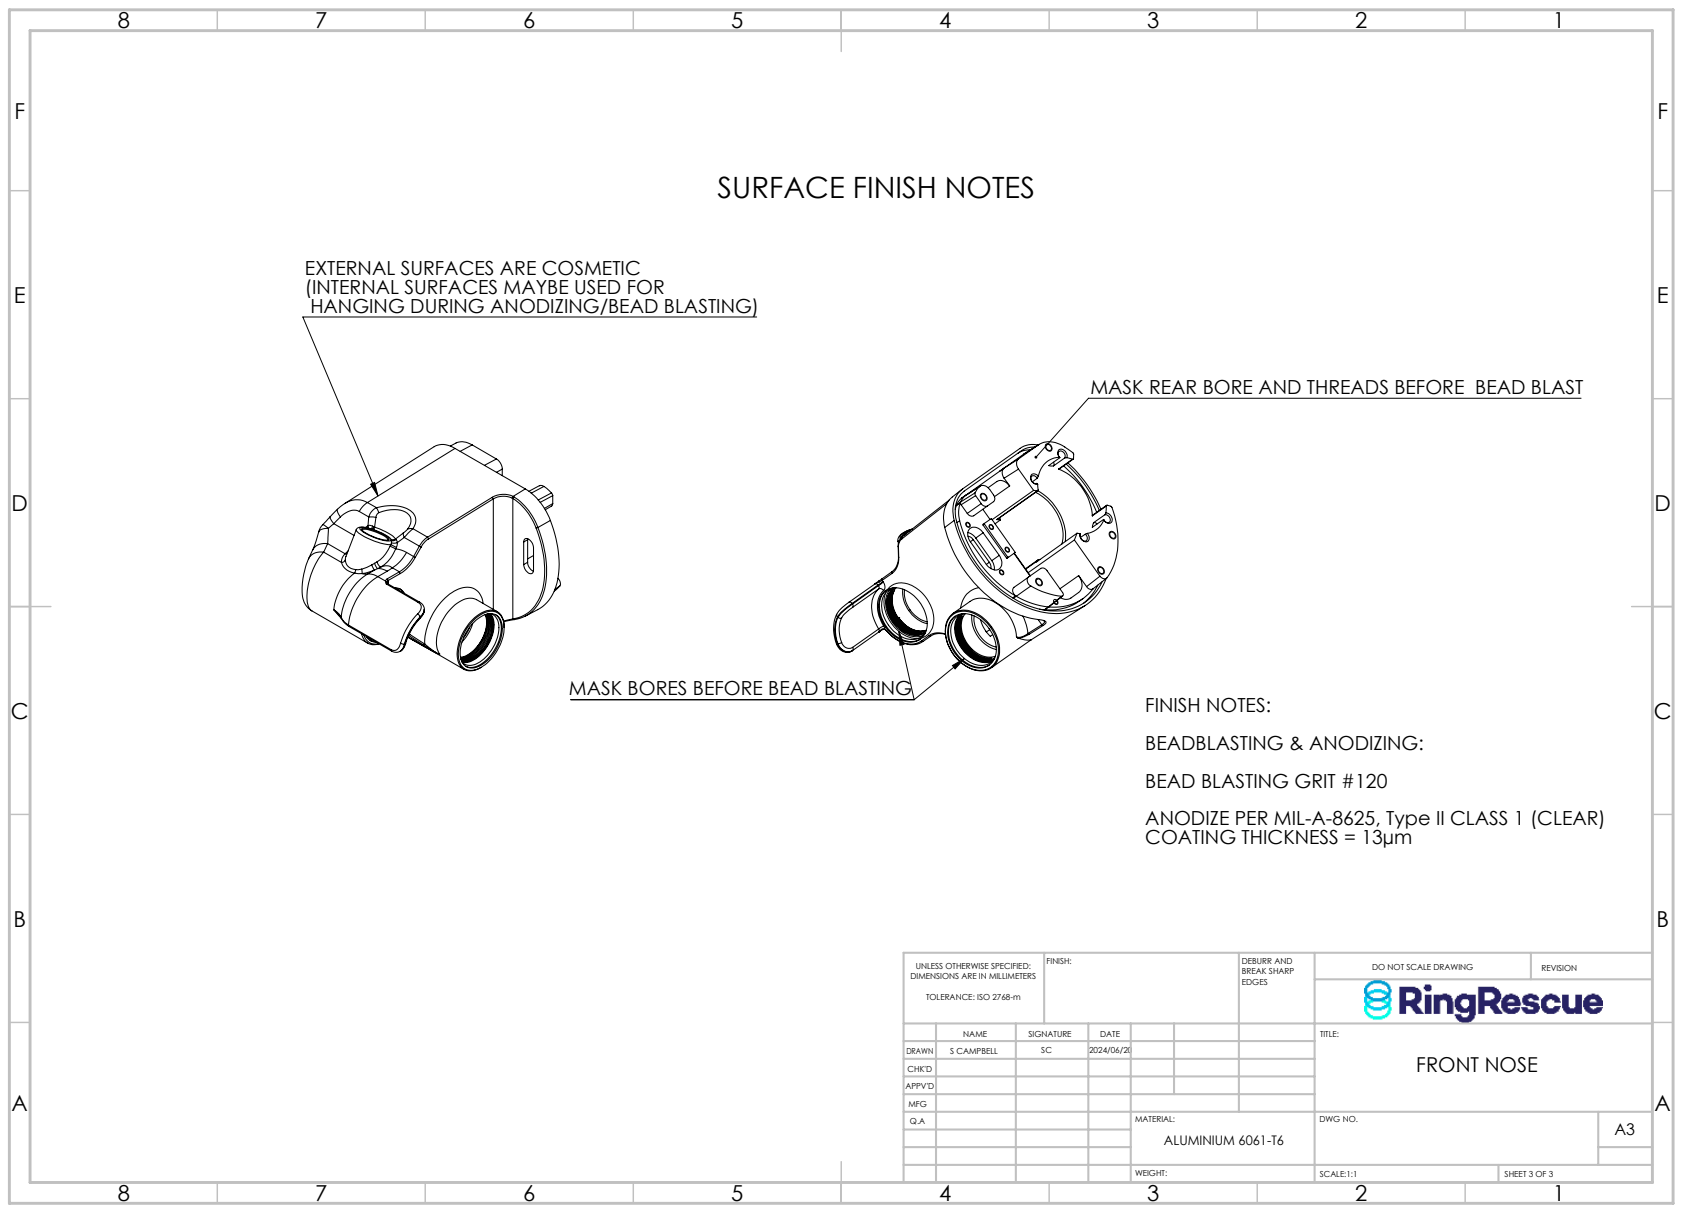
[picture p33: page 3]
FINISH:; DEBURR AND; BREAK SHARP; DO NOT SCALE DRAWING; REVISION

SURFACE FINISH NOTES

EXTERNAL SURFACES ARE COSMETIC
(INTERNAL SURFACES MAYBE USED FOR
HANGING DURING ANODIZING/BEAD BLASTING)

MASK REAR BORE AND THREADS BEFORE BEAD BLAST

MASK BORES BEFORE BEAD BLASTING

FINISH NOTES:
BEADBLASTING & ANODIZING:
BEAD BLASTING GRIT #120
ANODIZE PER MIL-A-8625, Type II CLASS 1 (CLEAR)
COATING THICKNESS = 13µm

UNLESS OTHERWISE SPECIFIED:
DIMENSIONS ARE IN MILLIMETERS
TOLERANCE: ISO 2768-m

NAME | SIGNATURE | DATE | TITLE:

DRAWN | | SC | 2024/06/20 | FRONT NOSE S CAMPBELL
CHK'D
APPV'D
MFG
