scottcampbellRR/SolidWorksFiles/Machined Parts - 2024-10-08/Shoulder Bolt Drawing.PDF

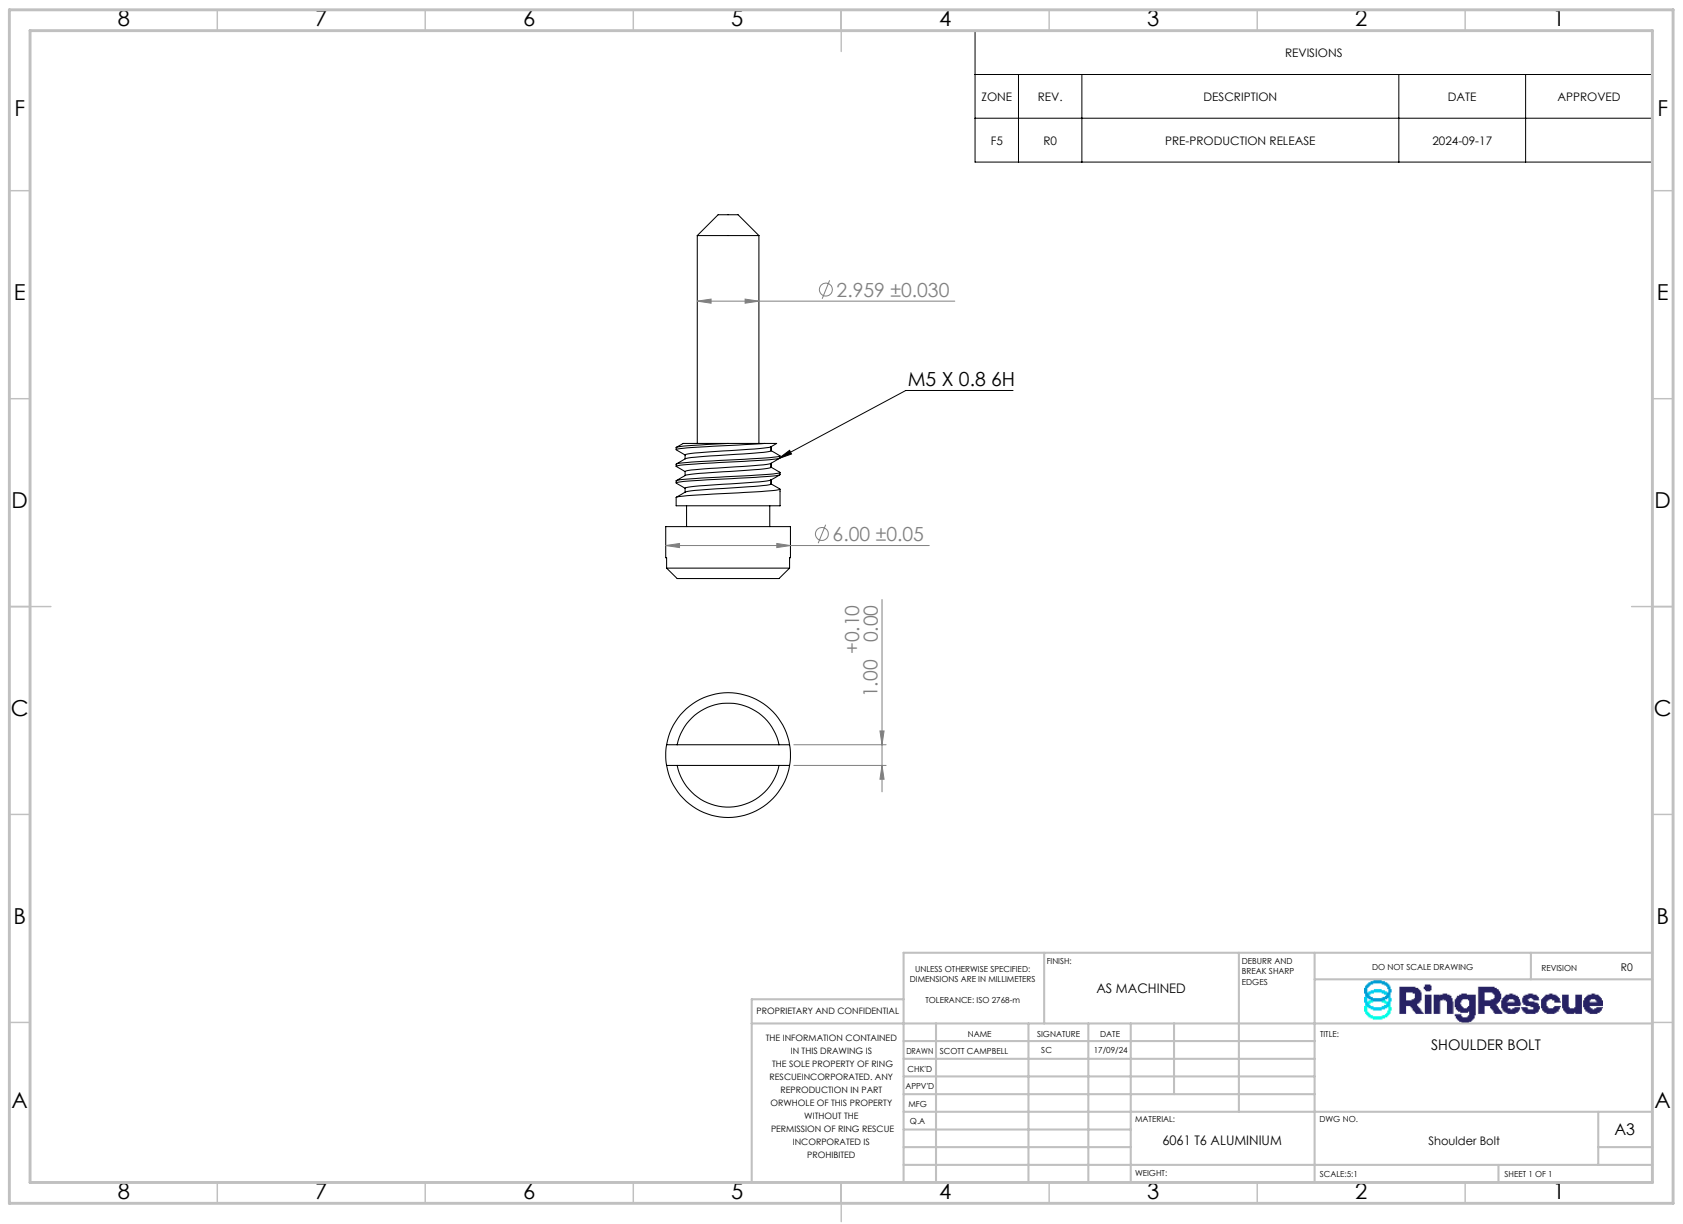
[picture p37: page 1]
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

REVISIONS

ZONE | REV. | DESCRIPTION | DATE | APPROVED

F5 | R0 | PRE-PRODUCTION RELEASE | 2024-09-17

UNLESS OTHERWISE SPECIFIED:
DIMENSIONS ARE IN MILLIMETERS
TOLERANCE: ISO 2768-m

PROPRIETARY AND CONFIDENTIAL

IN THIS DRAWING IS THE SOLE PROPERTY OF RING RESCUEINCORPORATED. ANY REPRODUCTION IN PART ORWHOLE OF THIS PROPERTY WITHOUT THE PERMISSION OF RING RESCUE INCORPORATED IS PROHIBITED | | NAME | SIGNATURE THE INFORMATION CONTAINED | DATE | | | TITLE: SHOULDER BOLT

DRAWN | SCOTT CAMPBELL | SC | 17/09/24
CHK'D
APPV'D
MFG
Q.A | | | | MATERIAL: | DWG NO. Shoulder Bolt | A3 6061 T6 ALUMINIUM
