scottcampbellRR/SolidWorksFiles/Machined Parts - 2024-10-08/Thumbscrew Drawing.PDF

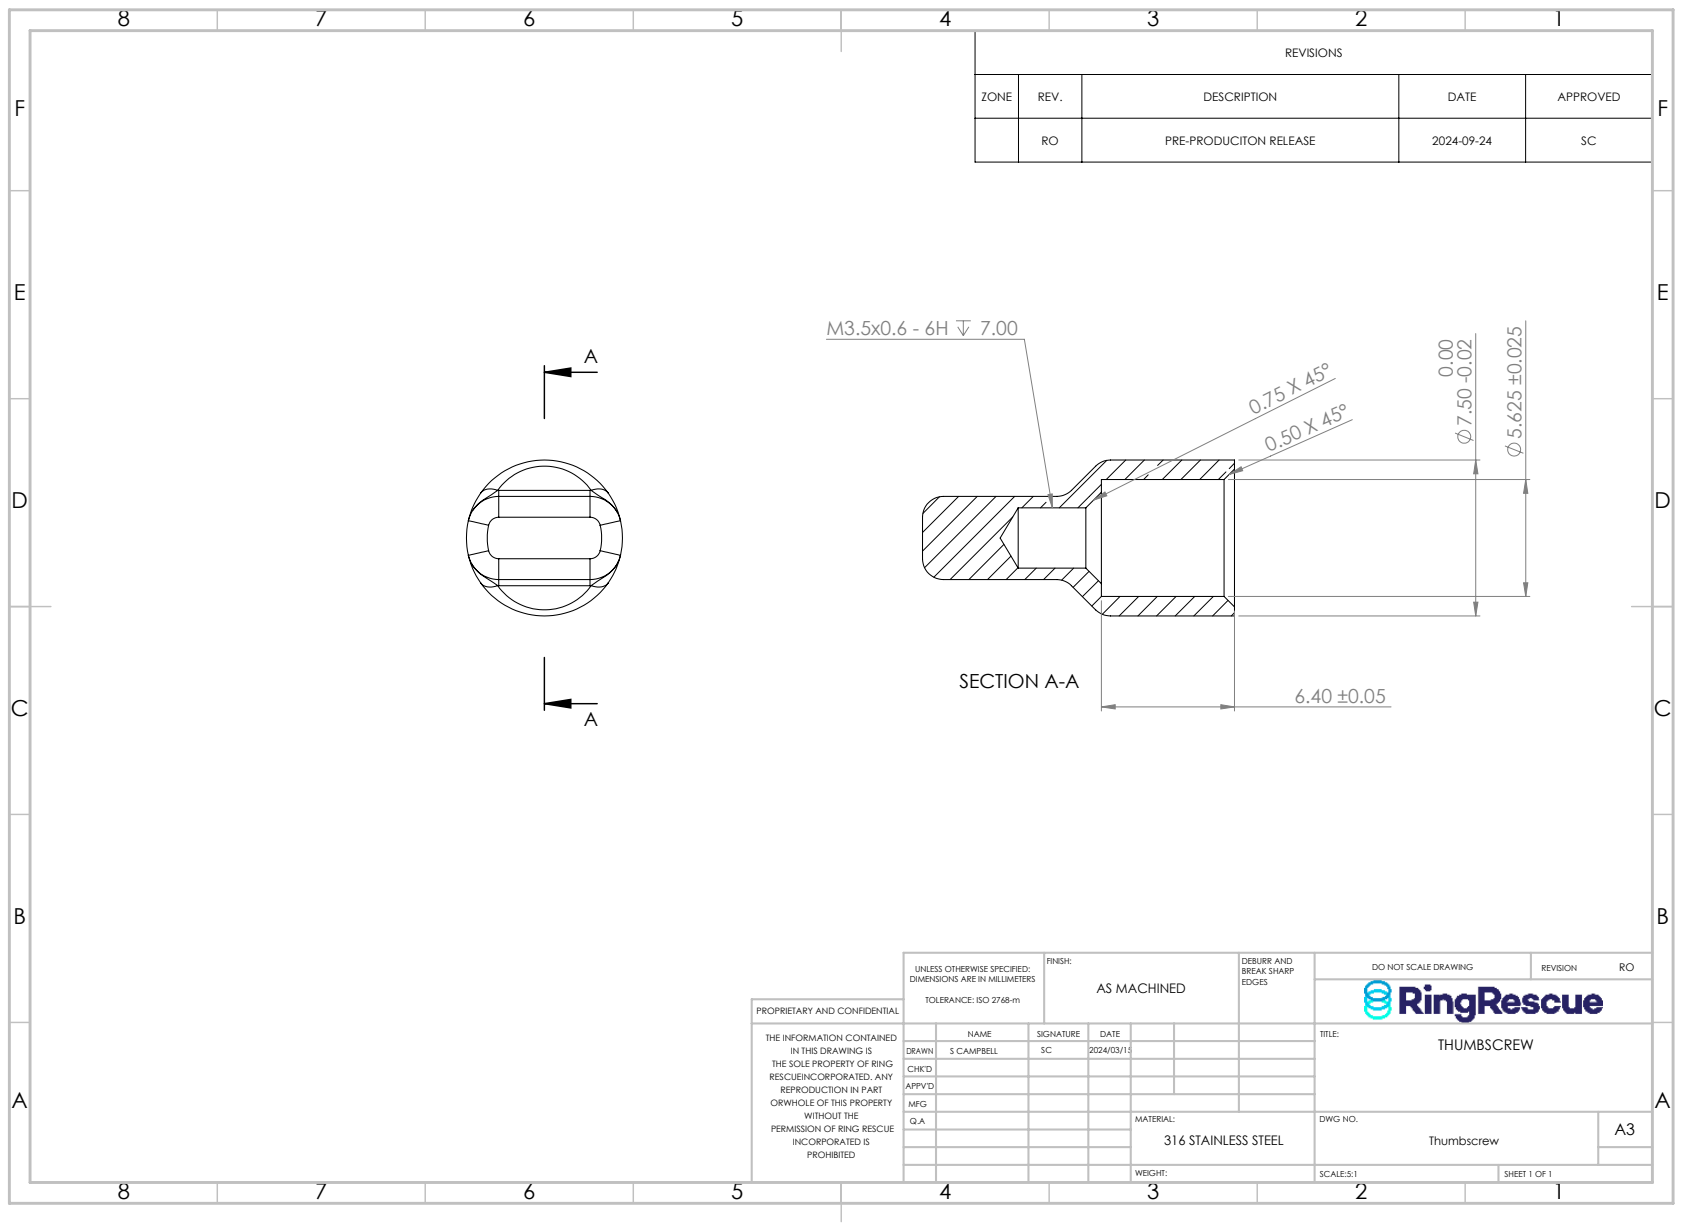
[picture p38: page 1]
SECTION A-A; FINISH:; DEBURR AND; BREAK SHARP; DO NOT SCALE DRAWING; REVISION; SCALE:5:1; SHEET 1 OF 1; AS MACHINED

REVISIONS

ZONE | REV. | DESCRIPTION | DATE | APPROVED

RO | PRE-PRODUCITON RELEASE | 2024-09-24 | SC

UNLESS OTHERWISE SPECIFIED:
DIMENSIONS ARE IN MILLIMETERS
TOLERANCE: ISO 2768-m

PROPRIETARY AND CONFIDENTIAL

IN THIS DRAWING IS THE SOLE PROPERTY OF RING RESCUEINCORPORATED. ANY REPRODUCTION IN PART ORWHOLE OF THIS PROPERTY WITHOUT THE PERMISSION OF RING RESCUE INCORPORATED IS PROHIBITED | | NAME | SIGNATURE THE INFORMATION CONTAINED | DATE | | | TITLE: THUMBSCREW

DRAWN | S CAMPBELL | SC | 2024/03/15
CHK'D
APPV'D
MFG
Q.A | | | | MATERIAL: | DWG NO. Thumbscrew | A3 316 STAINLESS STEEL
