scottcampbellRR/SolidWorksFiles/Machined Parts -2025-04-07-R01 RELEASED/RCDT-PR-003 Bore Cap Drawing R01.PDF

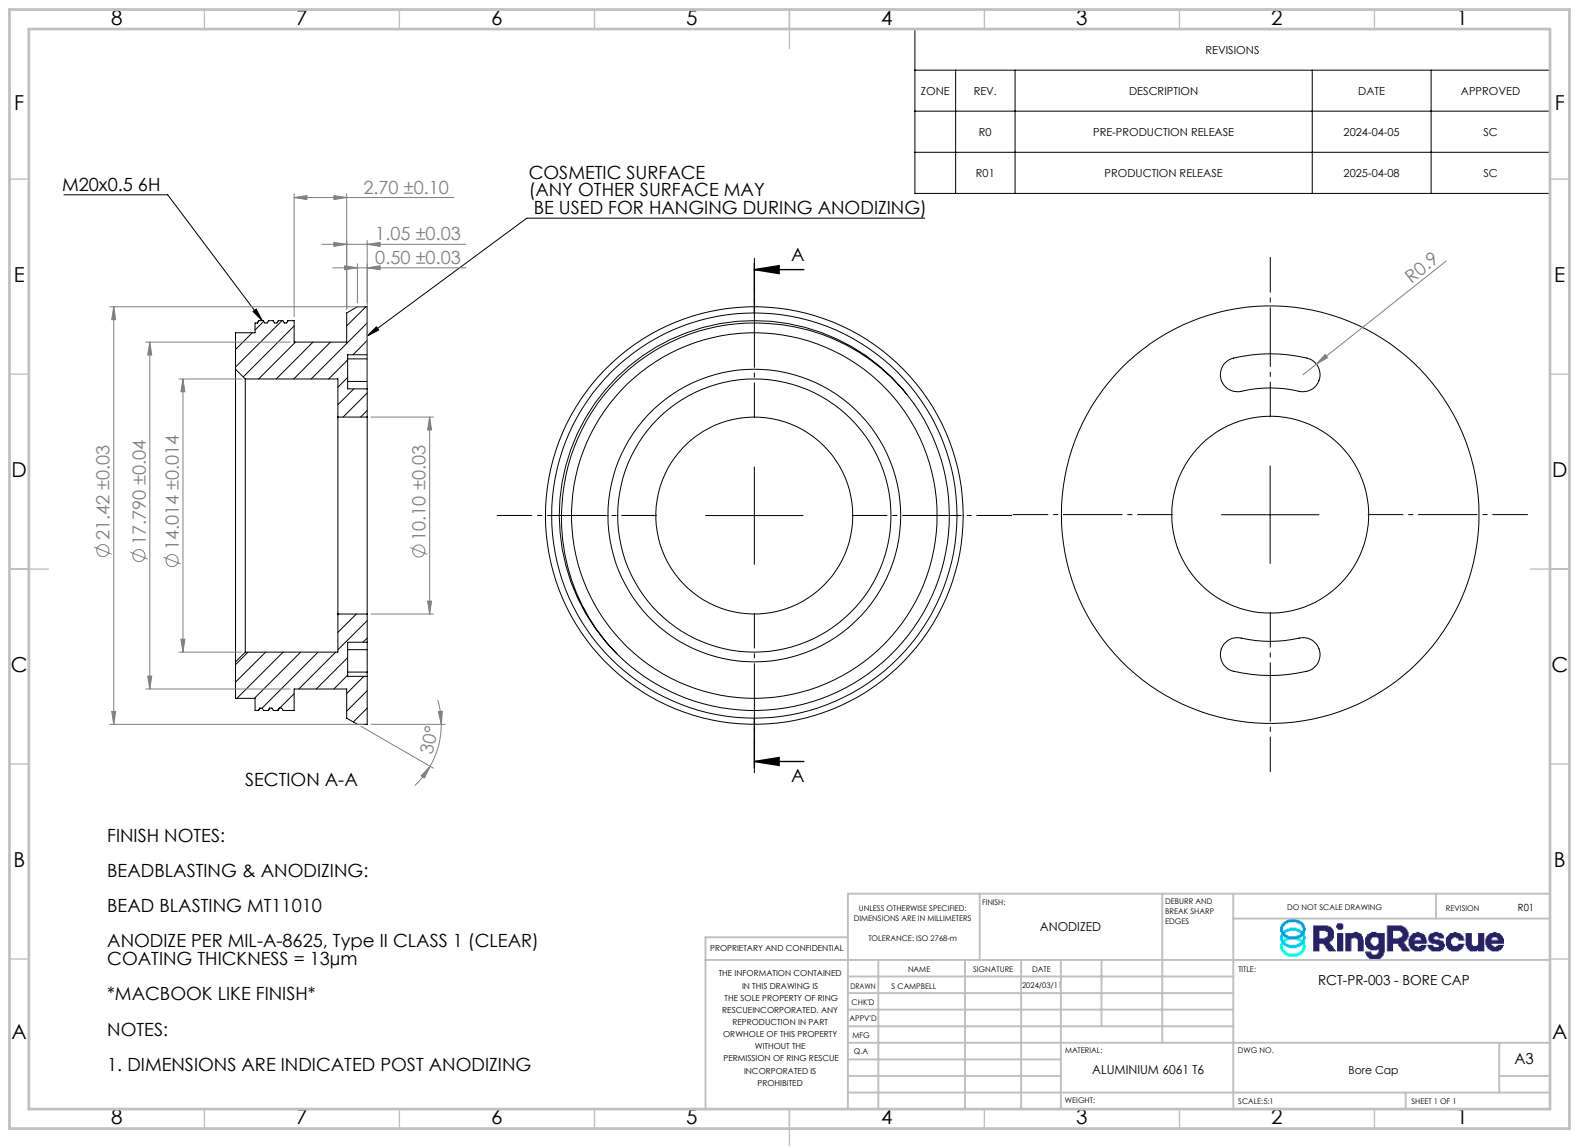
[picture p39: page 1]
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

REVISIONS

ZONE | REV. | DESCRIPTION | DATE | APPROVED

R0 | PRE-PRODUCTION RELEASE | 2024-04-05 | SC

COSMETIC SURFACE
(ANY OTHER SURFACE MAY
BE USED FOR HANGING DURING ANODIZING)

R01 | PRODUCTION RELEASE | 2025-04-08 | SC

FINISH NOTES:
BEADBLASTING & ANODIZING:
BEAD BLASTING MT11010
ANODIZE PER MIL-A-8625, Type II CLASS 1 (CLEAR)
COATING THICKNESS = 13µm
*MACBOOK LIKE FINISH*
NOTES:
1. DIMENSIONS ARE INDICATED POST ANODIZING

UNLESS OTHERWISE SPECIFIED:
DIMENSIONS ARE IN MILLIMETERS
TOLERANCE: ISO 2768-m

PROPRIETARY AND CONFIDENTIAL

IN THIS DRAWING IS THE SOLE PROPERTY OF RING RESCUEINCORPORATED. ANY REPRODUCTION IN PART ORWHOLE OF THIS PROPERTY WITHOUT THE PERMISSION OF RING RESCUE INCORPORATED IS PROHIBITED | | NAME | SIGNATURE THE INFORMATION CONTAINED | DATE | | | TITLE: RCT-PR-003 - BORE CAP

DRAWN | S CAMPBELL | | 2024/03/11
CHK'D
APPV'D
MFG
Q.A | | | | MATERIAL: | DWG NO. Bore Cap | A3 ALUMINIUM 6061 T6
